Xiaomiju-x/rdk-x5-microduck/software/README.md

# D 短距离前进 · 公开运行包

本次完整方案的推荐软件入口：单一 D 控制台、板端串口运行、400 帧相对轨迹、分段颈部角度、提前收颈、完整单轮与连续 2/3/5 轮、只读检查及托稳慢复位。

建议从 [v2026.10.27.1 固定 Release](https://github.com/Xiaomiju-x/rdk-x5-microduck/releases/tag/v2026.10.27.1) 开始。首次复刻按 [FIRST_RUN](../docs/FIRST_RUN.md) 完成编号、站姿和 IMU 方向；完整安装命令在 [DEPLOYMENT](../DEPLOYMENT.md)。公开包标识为 `D_PUBLIC_CASE_20261027_R1`，用于区分新增诊断与兼容修订，不表示D动作基线发生变化。

**10 月 23 日实机成功的是当时的完整集成与参数。这里的便携运行包从该实现提取，已做离线轨迹、算法和串口目标包对照，未在发布过程中新增实机试跑。** 参数不是所有复刻机器通用的标定值。连续多轮功能已完成软件检查，连续稳定行走仍需实物验证。

## 无硬件快速预览

需要 Python 3.10+。进入本目录，在自己的虚拟环境运行：

```sh
python -m pip install -r requirements-tested.txt
python -m unittest discover -s tests -v
python runtime.py plan --cycles 5
python app.py --demo --port 9194
```

打开 <http://127.0.0.1:9194/>，顶部显示 **DEMO · 无硬件**。运行、复位按钮仅演示界面，不读取串口、不发送目标。已有程序占用 9194 时，换未占用端口；不要关闭正在使用的实机控制器。

`plan` 只读本地文件，输出 `execute=false`、`motion_writes=0`。5 轮为 2000 帧，每轮名义约 8.23 秒，真实串口开销会增加耗时。

## 板端部署

先阅读 [部署与逐机配置](../DEPLOYMENT.md)。软件直接放在 X5 运行，不需要原开发者的用户名、绝对路径或 SSH 配置，也不需要 ONNX 权重和训练服务器。

```sh
python app.py --robot .local/robot.json --port 9194
```

服务仅监听 `127.0.0.1`。电脑通过 SSH 本地转发：

```sh
ssh -L 9194:127.0.0.1:9194 your_user@your_x5_address
```

再打开电脑的 <http://127.0.0.1:9194/>。本地和板端使用同一个端口；如占用，一起改成同一个空闲端口。本机接口还使用同源检查和每次启动生成的控制令牌，避免第三方网页误发动作请求。

启动服务只载入配置和界面。**运行和复位必须由操作者勾选当轮现场状态并点击对应按钮；只读检查可以单独读取串口，不发运动。** 刷新回单轮，现场勾选清空；保存参数和选轮数不发动作。

## 默认成功参数

|参数|默认值|含义|
|---|---:|---|
|启动角度 `bias_deg`|0°|相对本机 START；正值颈根后移、负值前移|
|走动角度 `motion_deg`|−30°|相对本机 START 的前移请求|
|起步保持 `start_hold_s`|0 秒|腿部动作开始后立即进入颈部平滑过渡|
|过渡 `transition_s`|0.2 秒|从启动角向走动角过渡|
|提前收颈 `return_advance_s`|1.1 秒|相对原收颈时刻提前，按 50 Hz 轨迹时间|
|前倾/后倾反馈增益|0 / 0|成功演示采用分段定角，无自动倾斜反馈叠加|

−30°是请求角，每拍颈部变化速率和提前收颈共同决定实际下发过程，不表示实物一定达到或保持前移 30°。`0°`是真正的本机 START。[默认文件](config/success_20261023.json)。

建议单轮起步，一次只调一项并记录现象。启动前倒可增加正向启动角；走动后倒可增加走动前移；收步前倒可逐步增加提前收颈。提示仅针对已核实的 11 号方向，实际效果取决于装配、载荷和地面。

## 完整周期

150 帧准备 → 100 帧历史小动作 → 100 帧平滑回 START → 50 帧保持。提前收颈可与腿部运动重叠。

连续 2/3/5 轮调用相同完整周期，每轮重新建立 IMU 参考、颈部时钟、20 秒期限和读取重试预算。不会只循环中间 100 帧，不自动开启下一批。操作者停止、通信/失能故障、IMU 停更或一轮不完整，均不继续下一轮。

程序完成只说明目标序列完成和最终目标回到 START；是否站稳、是否前移需现场观察。当前 D 是记录目标序列加颈部调节的过渡方案，非完整全身 RL 闭环。

## 文件导航

|文件|用途|
|---|---|
|`app.py`、`web/`|仅 D 的微调台；默认 DEMO，硬件模式显式选配置|
|`runtime.py`|计划、只读检查、姿态捕获、托稳复位、有限轮数运行|
|`imu_diagnostics.py`|独立 IMU 只读检查：两类包频率、轴向、前后倾与数据年龄；不碰舵机|
|`neck.py`|原颈部算法，只修改导入路径|
|`contract.py`|原 D 的包格式、范围、每拍速率检查|
|`feedback.py`、`bounded_read.py`、`confirm_write.py`|真实反馈、有限读取重试、写超时只读确认|
|`imu.py`|JY901S 解码和独立读取线程，不写配置|
|`data/d_trajectory.json`|400 帧逐轴相对 START 增量与原时间间隔|
|`data/reference_pose_NOT_A_DEVICE_CONFIG.json`|历史原型参考，仅供比对，不是新机配置|
|`data/provenance.json`、`data/offline_equivalence.json`|来源、校验和、原实现目标包等价证据|
|`config/robot.example.json`|逐机配置空模板，不能直接发动作|
|`tests/`|假串口、假 IMU、假时钟离线测试|
|`vendor/feetech.py`|上游总线实现，来源和许可见下文|

配置、保存参数、逐轮记录位于 `.local/`，默认已忽略，不要将设备标识和未审阅日志提交到公共仓库。

## IMU 独立检查

填好本机 `imu_port`、`imu_baud` 和候选 `body_from_sensor_rotation` 后，可在尚未确认安装标志时只读验证：

```sh
python runtime.py imu-check --robot .local/robot.json --seconds 8
```

不打开舵机口、不使能、不写目标、不改配置。每约 0.25 秒输出传感器欧拉角/角速度、机体重力/角速度、相对首帧的 `pitch_delta_deg`、数据年龄；结束统计 0x53 和 0x52 的主机接收频率。正的 pitch_delta 表示前倾，负值后倾，必须与支撑状态下的实际倾斜对照。示例矩阵和输出含义见 [FIRST_RUN 的 IMU 部分](../docs/FIRST_RUN.md#5-imu安装方向与只读验证)。

`inspect` 只读舵机，`imu-check` 只读独立 IMU。前者通过不代表后者已通过。结束其他占用 IMU 口的任务后再运行检查；工具不自动将验证标志设为 true。

## 本版离线环境与检查

2026-10-27 在 Windows x86_64、CPython 3.12.14、NumPy 2.2.6、pyserial 3.5 通过 34 项回归（原 24 项 + 10 项 IMU 诊断）。`requirements-tested.txt` 固定此依赖组合；原 `requirements.txt` 保留兼容范围。CI 会在 Windows/Linux、Python 3.10/3.12 运行，不以配置存在代替远端通过记录。

本版新增诊断 CLI 和教程，没有修改 D 数据、neck 算法、成功预设或动作函数。1/2/3/5 轮位置包的原 SHA 断言仍通过。`data/offline_equivalence.json` 是 10 月 26 日原版本历史证据，里面的 runtime 文件 SHA 对应该版本；新增代码的回归证据见 `verification/offline_20261027.json`。

## 停止与复位

- **停止发目标**：结束当前动作，不进下一轮，保持最后目标，不自动失能或猛拉 START。
- **只读检查**：读取 ID、模式、offset、扭矩、位置、目标、电压，不使能。
- **慢复位**：托稳躯干和头部、双脚卸重。先设刚读到的实际位置为目标，再使能失能关节，随后低速回 START。不改 P/D、offset 或 EEPROM。
- **仅复位可恢复关节**：只处理检查通过、离 START 不超过 512 counts（45°）的关节；其余记入 skipped。部分完成不是整机复位。

故障不自动复位，因为设备失联或姿态不明时无法确认回位路径；先支撑、读取状态，再显式决定复位。

## 来源与验证边界

本包新增代码按根 [Apache-2.0](../LICENSE) 发布。`vendor/feetech.py` 来源于 [fanhao375/microduck-replica 的 tools/servo-web 实现](https://github.com/fanhao375/microduck-replica/tree/master/tools/servo-web)，保留上游归属与 Apache-2.0 许可。本修订仅将一处调试日志中的字节串先格式化再插入 f-string，使 Python 3.10/3.11 也能解析；协议、状态解码与动作指令不改。原文件 SHA 与改动说明见 [vendor/README.md](vendor/README.md)，许可见 [vendor/LICENSE](vendor/LICENSE)。结构、媒体及上游模型许可见 [NOTICE.md](../NOTICE.md)。

离线检查包括：400 帧增量和时间间隔与原候选一致；颈算法只改导入；同输入下原运行器与公开运行器 1/2/3/5 轮位置包逐字节一致；停止和故障不续跑；只读捕获无写；复位使能顺序；界面互斥、现场确认和同源访问。不是动力学或新实机稳定性验收。
