Xiaomiju-x/rdk-x5-microduck/progress/2026-10-27/README.md

# 2026-10-27｜24章完整教程与单电池启动进展

**现场实测：复用现有成品5V舵机电池，经微雪DC+/DC−分供后，RDK X5和15个舵机均能正常供电、启动。** 不新增降压或稳压模块；该结果属于当前单电源配置的启动验证。

## 与此前成果的关系

- 10月23日全机载短距离前进视频仍对应双电池配置，不改写为单电池行走。
- 当前确认的是X5与15舵机供电启动；单电池带载行走、连续运行、板端动态电压、温升和续航尚待记录。
- R9竖电池、低位贴身X5和局部让位壳已设计、切片并送印；实配与最终装载表现待验证。
- 本次GitHub更新不连接机器人，不改D成功参数、START、P/D或动作代码。

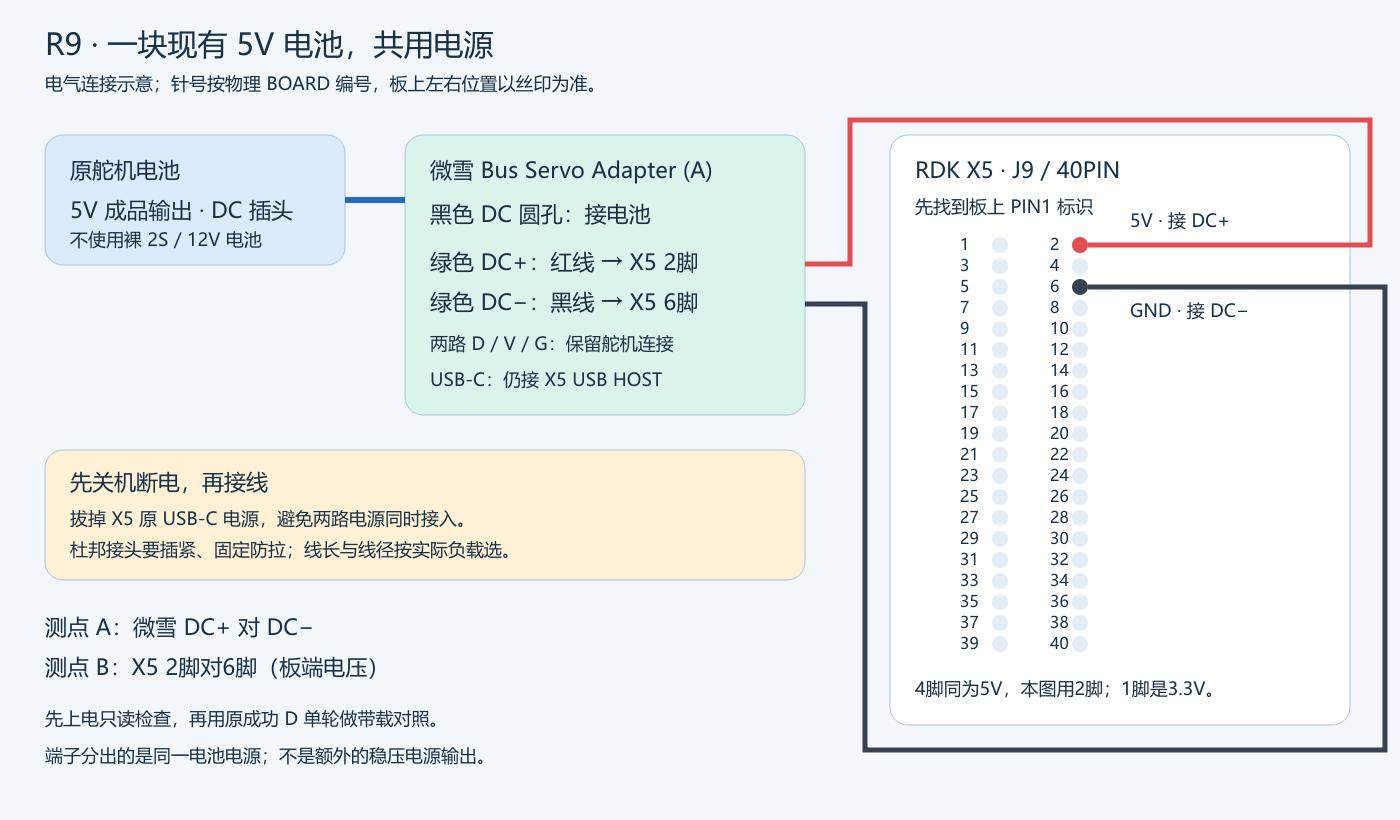
[picture p9: docs/images/r9/power_wiring.png]
单电源接线：已验证启动


来源为项目现场操作者反馈，文字记录见[single-power-startup.json](single-power-startup.json)。目前没有新增单电源动作视频或动态测量数据，不用旧媒体替代。

## 完整教程

新[完整复刻手册](../../docs/FULL_SOLUTION.md)分六篇24章：系统框架、采购、选件打印、分模块机械装配、接线、软件环境、15轴方向、IMU、START、控制台、分阶段微调、日志、MuJoCo实验和RL研究。配图存入仓库，目录和文内资源可直接跳转。

## 下一步

R9实配 → 单电池带载与连续运行验证 → 线束整理 → 同配置D单轮复现 → 2/3/5轮距离扩展 → RL闭环。

以现有RDK X5开发板继续推进，V2机内集成不作为当前迭代的前置条件。详细工作和验收见[ROADMAP](../../ROADMAP.md)与[单电池/R9说明](../../docs/SINGLE_POWER_R9.md)。

地瓜社区同版教程：https://forum.d-robotics.cc/t/topic/35728/1

固定运行/打印包仍为[v2026.10.27.1](https://github.com/Xiaomiju-x/rdk-x5-microduck/releases/tag/v2026.10.27.1)，本次不覆盖旧tag或将尚未实配的R9宣称为已验证打印基线。
