Xiaomiju-x/rdk-x5-microduck/projects/pumpkin-duck/MECHANICAL_NOTES.md

# 机械实装问题与版本说明

**本页是结项问题记录，不是已经验证成功的改装步骤。** 没有因为本次归档新增打印件或要求重新打印。

## 桌面舵机的两侧不能混为驱动输出

现场反馈是：网页发了目标，舵机回读接近目标，外部机构却没有明显动作。用户随后识别到机构连接在从动盘侧。

对原 CAD 继续核对发现，C02 等托架的主动侧连接器插入路径受到阻挡；只把舵机翻面又需要考虑托架背后的安装支撑。此前“简单翻面即可”的建议已撤回。这个问题属于设计/装配可达性漏检，不能归咎操作者或把软件角度放大当作修复。

结项时未提供新的已验收托架，也没有完成主动轴带动各工位的实测。原 C02、H05、E11/E01、F15、G09 等资料仍保留作问题源件，不作为可直接复刻的无误五工位方案。

## 面具快照采用的修正

- 前抱箍用 R1c：两个完整封闭孔，替代原半孔结构。
- 相机托架用 R1a：排针/接口让位版本。
- 语音托板用 R1b：平整泡棉粘贴背板；不使用旧 P06 卡边与两只 P07 隔套。
- 外壳、后抱箍、骨架、灯压片按已有选件保留；本次没有修改几何。

这些是归档文件的版本选择，不是对任意购买模块、插头、打印精度和新增整机载荷的完整保证。参见[零件表](mechanical/mask/README.md)。

## 其他实物修正保留在本地

原 21 盘与已交付修正文件保留，包括舵盘联轴孔、孵化导向与 KW11 胶粘安装图、只换轻薄南瓜壳、格栅导轨及打印方向的修正。用户已打印和装好的部分不因结项重新设计。最后握手叶片开关取消，孵化开关保留。

这些资料可以帮助理解原型过程；整套瓜园的最终装机运动、插头与线束可达性、种子触发和光学效果仍未全部验收。不能从离散 CAD 检查、切片成功或漂亮的装配图推定实物无误。
