Xiaomiju-x/rdk-x5-microduck/ROADMAP.md

# 后续安排：单电源带载升级 → 线束优化 → 更长距离 → RL闭环

更新：2026-10-30。[当前单电源样机](docs/CURRENT_PROTOTYPE.md)已能正常供电、启动和站立；带载行走出现供电不足表现，不能将此前双电池的成功录像作为本版验收。

已采购2S 1000mAh 45C航模电池、好盈5A UBEC、分线/转接线与S10充电器，预计11月2～8日到货，具体以物流为准。近期继续使用现有RDK X5、微雪Bus Servo Adapter (A)、HD1910M与JY901S，不等待V2机内集成。[采购与新接线计划](progress/2026-10-30/README.md)

| 顺序 | 具体工作 | 应交付的结果 |
|---|---|---|
| 新单电源带载 | 2S电池分供舵机与5.0V UBEC/X5支路，做同动作对照 | 两端电压、通信、关节跟随和连续运行记录 |
| 电池与UBEC固定 | 优先复用现有轻量框架，核实固定与02/07侧摆净空 | 正侧背照片、固定方式和活动余量 |
| 线束整理 | 收拢双UART与供电主线，固定接头并留关节余量 | 无夹线和拉脱，接口可维护 |
| 单轮复现 | 保留已验证D基线，按新装载微调起停配合 | 完整起步/前进/收步视频及参数 |
| 距离扩展 | 验证2/3/5完整轮，再研究平滑连续衔接 | 距离、偏航、接护、起停、电量与温度 |
| RL闭环 | 当前实装建模、执行器辨识、训练与部署对齐 | IMU/关节反馈影响全身动作的实机证据 |

## 1. 单电源：从能站立推进到带载行走

旧成品5V电池同时带X5和舵机已经能启动和站立，但带载出现关节跟随无力、复位不到位及低电压回报。新方案已采购，尚未验证：

```text
2S航模电池 → T插一分二
              ├→ DC5521 → 微雪小板 → 15只舵机
              └→ UBEC（输出5.0V）→ RDK X5
```

**更换2S前，拆除旧微雪DC端直供X5的连接。2S电压不得直接进入X5的5V输入。** 原5V直分供接法仅保留为历史实验，不作为新2S方案。

先核输出电压与极性，再做只读检查、支撑慢复位及同动作带载对照，记录X5板端和舵机支路的电压、跟随、通信与温升。舵机回报电压不替代X5输入端测量；新电池未验证前不宣称故障已经解决。

10月23日双电池短距离前进与冻结参数保留为对照；改变电池重量与位置后，还需要重新比较起步、走动和收步的前后平衡。

## 2. R9：竖放电池、X5下移贴身、局部外壳让位

原平放电池横跨较宽，容易进入02/07髋侧摆活动区；早期远悬背包又增加后坠力矩和连接负担。本轮把减重、缩短悬臂和关节净空一起处理，优先减少一块电池和不必要支架。

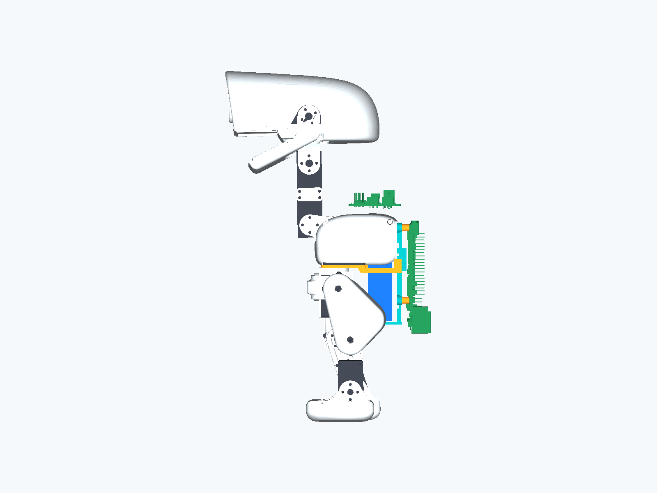
[picture p12: docs/images/r9/R9_side.png]
R9候选布局，待实配


- 电池按40×19×70mm竖放，70mm长边竖起，横向占位由70mm改为40mm。
- X5相对保存的R8A CAD下移24mm、内收约3.64mm。这是CAD差值，不是成功照片的实测差值。
- 新L1根座、L2轻量托架、C1/C2局部让位壳各1件，旧四个6mm隔套复用。
- 先离机装螺母、隔套和PCB，再放电池并接入根座，保持螺母装入与工具空间。
- 微雪使用固定躯干部位的合适位置，保留IMU已确认的刚性安装和朝向；胶粘和线束不进入活动关节。

已完成内部干涉、93个离散姿态、紧固叠层和螺母装入路径检查，切片并送印。整盘约53.83g、2小时44分是含替换壳和支撑的估计，不是新增背包净重；移除一块电池历史约84g，最终总质量和质心仍需实测。

现有单电源实装已经能够站立；新电池和UBEC到货后继续核对固定方式、02/07侧摆、真实线束包络和根座承载，再做同D动作对照。当前仓库制造资产仍为R8A，R9本次同步说明与示意图，不把设计检查当作强度或带载行走验收。见[R9专章](docs/SINGLE_POWER_R9.md)。

## 3. 减少线缆裸露和跨关节绕线

**目的：** 降低勾线、插头松动和线缆牵拉对行走的影响，提高整机一致性与展示完整度。

优先安排：

1. 利用已接入的40PIN双UART，沿固定躯干集中布置IMU、微雪通信和动力主线，缩短过长的回绕线。
2. 给连接器增加适当的应力释放与固定点，线缆不承担电池或板卡重量。
3. 每个活动关节仅保留必要活动余量，避免在双腿之间形成大线圈。
4. 给X5与微雪设计轻量导线槽、局部护盖或卡扣；不先增加厚重整包外壳。
5. 保留电源开关、USB、调试接口、散热与检修空间，并给两条供电支路和总线做标签。

验证时覆盖髋、膝、踝、头颈的实际使用姿态：无拉紧、夹线、明显剥离和插头受力。记录新打印件与线束的增加/减少质量，用正侧背三面图更新装配教程。

## 4. 从短距离前进扩展到长距离

**当前起点：** D单轮的腿部片段与颈部参数已保存；控制台提供完整1/2/3/5轮。每轮都有准备、动作、回位与保持，多轮入口不等于连续无停顿步态。

推进顺序：

1. 保持同一硬件、地面、电量和参数，记录单轮起步及收步的重复性。
2. 由操作者逐级测试2、3、5完整轮，记录累计距离、偏航、是否接护、每轮起止状态。
3. 区分“某一轮失稳”和“轮间重新准备导致的偏移”，再决定是否设计连续衔接动作。
4. 进入更长距离时，持续记录关节跟随、供电变化、温度与运动频率，不单纯扩大摆角。
5. 选定目标距离和场地后再冻结对应配置，用完整连续视频和原始日志说明测试条件。

建议记录表：

| 版本 | 地面 | 电量/电源 | 轮数 | 实测距离 | 接护次数 | 最后站稳 | 偏移方向 | 日志/视频 |
|---|---|---|---:|---:|---:|---|---|---|
| 按实际填写 | 按实际填写 | 按实际填写 | 1/2/3/5 | 测量值 | 观察值 | 是/否 | 前/后/侧 | 文件名 |

长距离阶段的成果以具体测试记录确认，不把软件帧数直接换算成行走米数。

## 5. 验证真正的RL实时闭环

**目的：** 让控制器根据实时姿态、角速度、关节位置和速度持续产生动作，逐步获得适应扰动、负载和起停的能力。

与当前D的区别：D主要使用记录的腿部目标序列和颈部时序；IMU数据接入、故障检查和舵机自身位置控制，并不等于全身RL平衡策略已验证。

| 环节 | 后续工作 | 检查结果 |
|---|---|---|
| 实物参数 | 测实际装载后的质量分布、START几何、执行器带载响应、通信时序与脚底接触 | 用测量替代旧照片估计；保存模型与实物版本对应关系 |
| 仿真模型 | 从本次FT教学模型继续，补正确惯量、附加载荷、执行器、延迟和接触条件 | 静态姿态、逐轴方向、小幅响应与实物对照 |
| 训练环境 | 固定观察量、动作顺序、缩放、滤波、历史状态、命令与奖励 | 训练/导出/运行三个阶段一致的配置文件 |
| GPU训练 | 有需要时使用RTX5090资源训练和评估 | 记录环境数、步数、随机种子、代码版本与权重，不以有GPU代替验证 |
| 离线评估 | 站立、前进、收步、延迟与载荷变化 | 分任务评估，记录失败样例和指标 |
| 实机部署 | X5读取IMU与关节反馈并推理，依次做卸重、零速接管、短前进和长前进 | 完整日志与现场视频共同确认，不将悬空正常等同带载行走通过 |

D基线继续保留用于设备检查与结果对照。新策略作为独立版本，不覆盖已经成功的参数与轨迹。

## 6. V2与项目分工

- **RDK主线：** 现有X5开发板原型按新单电源带载对照、固定与净空、线束、单轮与长距、RL闭环推进，形成可复刻、可比较的版本。
- **V2硬件：** 与硬件同事协作推进X5 Module和专用底板机内集成，结合单电池、配电和线束布局设计；不沿用外悬重背包作为最终形态。
- **陆吾XGO-Duck副线：** 作为独立平台的行走和部署对照，不把它的模型、舵机零位或策略直接写入FT鸭子。
- **南瓜鸭副线：** [2026-10-30 已结项归档](projects/pumpkin-duck/README.md)，不再主动开发、训练或安排联调。[面具的感知/表达与瓜园互动拓展](projects/pumpkin-duck/EXTENSIONS.md)只保留未完成设计，不并入主线排期。

当前版本可以用于社区复刻和交流，以上工作按结果逐步发布，不承诺未经验证的完成日期。参与方式见[贡献指南](CONTRIBUTING.md)。
