Xiaomiju-x/rdk-x5-microduck/docs/PROCUREMENT.md

# 采购与打印清单：买对一套 RDK X5 Duck

> **最新进度｜2026-10-30：** 当前单5V电池样机已能正常供电、启动和站立，带载行走出现供电不足表现。已采购2S 1000mAh 45C电池、好盈5A UBEC（5.0V供X5）、分线/转接线及S10充电器，预计11月2～8日到货验证。[完整采购清单、新接线与后续安排](../progress/2026-10-30/README.md)。下文10月27日电源说明保留为历史；旧DC端子直供X5的接法禁止用于新2S电池，新方案尚未验收。

本页面向首次搭建者，配套 [硬件连接](../HARDWARE.md)、[完整装配](../ASSEMBLY.md) 和 [逐步验收表](BUILD_CHECKLIST.md)。资料核对日期：2026-10-27。表中保留10月23日双电池成功样机的采购基线。最新单电池方案已复用现有成品5V舵机电池，从微雪DC+/DC−分供X5和15舵机并正常启动；移除X5专用电池、暂不新增降压模块。带载与连续运行待验证，详见[最新接线与R9](SINGLE_POWER_R9.md)。

## 1. 先选对版本

| 要复刻的部分 | 本案例选定 | 不混用 |
|---|---|---|
| 执行器与本体 | FT / HD1910M，15轴 | XL330结构、陆吾关节零位、STS3215接口 |
| 机载主机 | RDK X5完整开发板 | X5 Module、Raspberry Pi Zero占位件 |
| 串口转接 | 微雪Bus Servo Adapter (A)，USB控制档 | 普通双线UART当作三线舵机半双工总线 |
| 结构增量 | R8A L1、L2、6mm隔套 | 旧远悬背板、旧R8未开下螺母通道L2、8mm隔套 |
| 足底 | FT左右原形状，TPU95A HF | 把硬脚掌或踝座也换成TPU |

## 2. 电子件：可直接给采购同事的规格表

“本台记录”描述已经使用过的设备；“选购条件”供新复刻者核对。没有公开确切SKU的项目用完整规格和搜索词，不用外形相似的商品链接冒充本台原件。

| 项目 | 数量 | 本台记录 / 必须核对的规格 | 官方入口或采购搜索词 |
|---|---:|---|---|
| RDK X5开发板 | 1 | 完整开发板；预留电源USB-C、USB HOST与microSD；本资料未登记本台RAM档位 | [官方硬件说明](https://d-robotics.github.io/rdk_x_doc/en/Quick_start/hardware_introduction/rdk_x5/)；搜索“地瓜 RDK X5 开发板” |
| microSD | 1 | 容量满足所选官方镜像及日志；购买可靠品牌，按镜像文档准备读卡器 | 与所选RDK镜像要求一致；不把本案例写成某一容量实测 |
| 飞特HD1910M总线舵机 | 15 | FT源包标为HD-1910-C001；核对实物HD1910M、舵盘凸台、随附螺丝/线材、固件寄存器及模式；机械方案含单/双盘装配 | [FT v2.0来源](https://github.com/fanhao375/microduck-replica-cad/releases/tag/v2.0)；搜索“飞特 HD1910M HD-1910-C001 TTL总线舵机”，向厂家确认所供版本 |
| 微雪Bus Servo Adapter (A) | 1 | SKU25514；板框42×33mm；USB-C数据，DC5521，2路相同总线口；USB模式为B档 | [微雪国内产品页](https://www.waveshare.net/shop/Bus-Servo-Adapter-A.htm)；[规格](https://docs.waveshare.com/Bus_Servo_Adapter_A) |
| JY901S IMU | 1 | TTL串口款；本程序使用115200 baud、0x52角速度/0x53欧拉角，约50Hz；不同出厂默认值需配置 | 搜索“维特智能 JY901S TTL”；[厂家协议SDK](https://github.com/WITMOTION/WitStandardProtocol_JY901) |
| USB-TTL适配器 | 1 | 实机确切芯片SKU未登记；Linux驱动可用、TTL电平匹配IMU、115200稳定；不能买RS232/RS485款替代 | 搜索“USB TTL 串口模块 Linux 3.3V 115200”；CP2102/CH340等仅为候选类别，购买前核对电平与驱动，未作为本台同款认证 |
| 舵机成品稳压电池 | 1 | 历史购买规格5V/0–3A、2400mAh，DC输出；设计包络70×40×19mm，单块历史称重84g，线约15cm；精确店铺SKU未归档 | 搜索“5V 稳压锂电池 2400mAh DC5521 70×40×19”；要求商家给持续/峰值电流、极性、保护与充电说明 |
| X5成品USB-C电池 | 双电池基线1；单电池方案移除 | 同类外形、5V USB-C输出；本台额定电流及完整SKU没有独立归档，不能按另一块铭牌推断 | 搜索“5V USB-C 输出小电池 70×40×19”；确认是输出端、低负载不会自行断电、线与接头有足够电流能力 |
| 初期联调X5外置电源 | 1 | 按RDK官方要求5V/5A电源与匹配线缆；已有合规电源可复用 | [RDK硬件与供电](https://d-robotics.github.io/rdk_x_doc/en/Quick_start/hardware_introduction/rdk_x5/) |
| 舵机联调外置适配器 | 1，可复用 | 本项目曾用5V/4A外置适配器；输出电压必须匹配所购HD1910M，不能照板上ST系列电压字样选12V | 搜索“5V 稳压电源 DC5521”，核对极性和电流；板卡官方FAQ标称可承受5A，不等于所有线束可持续5A |
| USB-A→USB-C数据线 | 1 | X5 HOST至微雪；必须有数据线芯；尽量短且接头牢靠 | 搜索“USB A to C 短数据线”，按实际布局量长 |
| IMU USB线与排线 | 1套 | 适配器接口匹配，VCC/TX/RX/GND标清；供电与逻辑电平分别确认 | 与IMU/适配器配套，按引脚定义逐线核对 |
| 舵机三线总线 | 15段连接关系 | 两路树形分支，共含2根小板引出线及13根舵机间线；可复用厂家附线，按每段测量长度 | 搜索时携带舵机插头照片和针距；只写“杜邦线”不足以保证接头匹配 |

本表保留已成功样机的电池记录，但不把“本台短动作成功”扩展成这套电池覆盖15轴所有动作或X5满算力。复刻初期先把外置供电下的接线和控制跑通，再独立验证机载供电。无需为本D动作额外购买GPU、NPU扩展板或摄像头。

### 线束数量怎样来的

第一支路为左腿5只＋头颈嘴5只：1根板端线＋9根舵机间线。第二支路为右腿5只：1根板端线＋4根舵机间线。因此总计15段，不包含USB、IMU排线和两电源线。段数是拓扑计数，接头类型和每段长度依实际走线；不要把两支路末端再跨接成环。

## 3. 金属五金和工具

### 可确定的用量

| 项目 | 用量 | 用途及计数依据 |
|---|---:|---|
| 16×22×4mm金属轴承（内径×外径×宽） | 11 | FT作者用量，且固定FT总装树中相应大轴承实例11个；按每个圆座逐位装入 |
| 10×15×3mm金属轴承 | 3 | 两踝及下巴支撑；不是轮滑6×12×3占位对象 |
| M2.5×8螺丝 | 7 | 头内横梁4＋头盖3；头下长度，适合接收塑料孔的牙型按FT原件核对 |
| M3×16螺丝 | 2 | R8A L1/L2连接 |
| 普通M3螺母与M3平垫 | 各2 | 同上 |
| M2×12螺丝 | 4 | X5四孔，配6mm隔套 |
| 普通M2六角螺母与M2平垫 | 各4 | 同上；M2螺母约对边4mm、厚1.6mm，非加厚法兰款 |
| FT原腿根尾端螺钉 | 4，复用 | L1安装；不能拿舵盘中心螺丝代替 |
| 细绑带 | 原托盘2条；侧贴按实装 | 约10mm宽、≤1mm厚以配槽，长度先用软尺测量 |

舵机壳体/舵盘周边连接优先使用该批HD1910M原配小自攻。**整机原配小自攻总数和部分壳体固定长度尚未形成逐孔冻结表**；上游仅列“若干”的M2×5，不能替换成虚构的总数。采购时要求厂家随15只舵机提供足量安装包，并按[装配模块](../ASSEMBLY.md)清点；小自攻、M2机牙、舵盘中心螺丝不可混作一种。缺口填入下方预算表的“待确认”列，不当成零成本或已齐套。

### 工具与辅料

- 与实际螺丝头匹配的小号螺丝刀/内六角、镊子、尖嘴钳、模型剪钳、去支撑工具。
- 卡尺：核对孔、轴承、螺母和电池尺寸；万用表：核对供电极性与电压；秤：记录最终整机及附加件质量。
- PLA、TPU95A HF分别准备；高粘泡棉作固定与消隙，板底另留电气绝缘，不用线缆承重。
- 标签纸标每个舵机ID和打印件号；扎带、柔软束线带及线缆固定点。
- 平整防滑测试面与便于托举的工作区。打印机可自有或外包，不要求购买同型号打印机。

## 4. 打印清单：当前机载基准

| 组 | 文件入口 | 数量 | 材料 |
|---|---|---:|---|
| FT本体选定件 | [body_parts](../mechanical/body_parts/README.md) | 28个文件，各1件 | PLA |
| R8A根座 | `L1_R8_short_FT_root.stl` | 1 | PLA |
| R8A X5支架 | `L2_R8_flat_battery_portrait_X5.stl` | 1 | PLA |
| X5隔套 | `S1_R8_PCB_spacer_6mm.stl` | 4 | PLA |
| 左右脚底 | [tpu_soles](../mechanical/tpu_soles/) | 各1 | TPU95A HF |

基准共 **34个硬件实体＋2个TPU脚底**。28本体件包含眼圈和面板；可选软嘴018/044不计入，也不意味着成功样机使用这两件指定软料。R8A的L1替代上游052底板，故本体从29减为28。详细52对象决策：[FT_PRINT_SELECTION.csv](FT_PRINT_SELECTION.csv)。

不要打印：旧踝002/004、旧轴承压盖008/065、轮滑支架042/064、轮毂040/060/061/066、轮胎058/087/088/089、轮滑轴承占位063/067。原PCB锁扣006、镜头座025、原电源支架036也不进入这条X5外挂路线；027是**头内电机支架**，必须保留。

本体STL已经选定；本项目3MF提供R8A六件一盘、L2单件替换盘、左右TPU一盘，均需重新切片。整机本体按自己的机器安排盘数；不把P2S原工程直接发给P1S。

## 5. 可编辑源文件与固定版本

| 资料 | 固定下载 | SHA-256 |
|---|---|---|
| FT SolidWorks全套 | [SolidWorks-FT.zip / v2.0](https://github.com/fanhao375/microduck-replica-cad/releases/download/v2.0/SolidWorks-FT.zip) | `13764d844acec914b9e90fbf18f611d3d1c60b845a160710e0d694701cdba9b1` |
| FT改动STEP | [STEP-changed-parts-FT.zip / v2.0](https://github.com/fanhao375/microduck-replica-cad/releases/download/v2.0/STEP-changed-parts-FT.zip) | `cf137cd3c20b1ee115c5ba71993b42a993c9da337551a7f691d77870f5a61b0a` |
| 原始五盘3MF | [固定提交的打印目录](https://github.com/fanhao375/microduck-replica-cad/tree/22ecf4daea158f2dfad7b633f730a5c04f1e04e0/打印) | 原`microduck-飞特版-BambuStudio.3mf`：`de34a7808f97b3cc2b66dd24db94ddbe2fcd3b18691562f48dad3a094ecb5862` |

上游已存在更新版本，本案例固定既有FT基线以保证接口和选件可追溯；升级时单独对比尺寸，不在复刻过程中自动拉“latest”替换某一个件。只有9份改动STEP不能替代全套CAD；28本体STL加本包增量件则覆盖这里列出的打印基准。

## 6. 预算与用料如何填写

本次没有拿到可核对的完整订单金额，所以不发布猜测的“整机只需多少元”。建议复制下表，填自己下单当日含运费价格；已有部件可填0并注明复用，数量按上文清点。

| 预算项 | 计算方法 | 当前金额 |
|---|---|---|
| X5＋卡＋读卡器/电源 | 实际订单合计，去除已拥有项 | 待本次采购报价 |
| 15舵机＋原配附件＋总线 | 单价×15＋缺线/螺丝补件 | 待报价 |
| 微雪＋IMU＋USB-TTL＋USB线 | 逐项实价 | 待报价 |
| 两机载电源 | 2个实际SKU＋所需充电器/线 | 待报价 |
| 轴承/紧固件/泡棉 | 按规格表，不以“套餐数量”代替用量 | 待报价 |
| 打印 | 当前切片总克数×耗材每克成本＋外包/电费 | 按新切片记录 |

可供规划的历史记录：2026-09-14，P1S/0.4/PLA/0.2mm/6墙，**旧29件本体**六盘切片估计273.24g、12小时49分09秒，含当时支撑；不含软嘴、TPU脚底和现R8A增量。这不是当前34硬件＋2脚底的总用料或实际打印耗时。当前总量应从本次切片预览重新汇总。

## 7. 下单前最后核对

- 舵机外形、主动盘、副盘与FT图纸相符，15只的模式/寄存器版本可识别。
- 两电池分别具有**所需输出接口**；USB-C插孔不必然是输出，DC插得上不必然极性相同。
- 微雪是(A)版，USB数据线能通信；两只D/V/G为同一舵机总线。单电池方案从绿色DC端分供，按专章核对5V、物理针脚、导线与接头，启动验证不代替总负载测试。
- 正常金属轴承、正确牙型螺丝和X5下孔螺母已齐；不可打印轴承代替。
- 用选定STL/清单重新切片，确认最终装载方案没有额外打印一整套旧背包。

厂商资料负责接口规格，本案例负责实际集成路径；没有明示“实测同款”的替代件，均需自行验证。来源与许可见[NOTICE](../NOTICE.md)。
