Xiaomiju-x/rdk-x5-microduck/progress/2026-10-23/README.md

# 2026-10-23｜突破性进展：全套硬件上身后实现短距离前进

RDK X5机器鸭从“桌面外接控制链路”走到了“计算、驱动与供电随体”的新阶段：**X5、微雪小板和电池全部安装到本体后，已完成短距离前进，展示末段仍保持站立。** 这是本项目机载集成与带载运动的重要突破。

## 实拍证据

[▶ 完整实拍视频，约13秒](../../media/20261023/onboard-short-walk.mp4)

前段是短距离前进，后段展示整机与机载硬件。公开副本仅压缩编码并移除定位等元数据，未截断、倒放或改变播放速度；视频总时长不是连续前进时长。没有用未标定镜头估算厘米数。

| 正面 | 侧面 |
|---|---|
| 正面实拍 | 侧面实拍 |

两张照片展示当前装载状态，不能代替精确质量、质心或惯量测量。

## 控制方式与冻结配置

本次使用D历史小动作：固定的历史下发目标片段，叠加**仅11号颈根的分段定角与提前收颈**。其余14轴目标及节奏不因颈部微调而改变，不运行全身在线RL策略。

| 控制台项目 | 本次保存值 |
|---|---:|
| 启动颈根角，相对本机START | 0° |
| 走动颈根角，请求值 | 前移30°（代码为−30） |
| 小动作开始后保持 | 0秒 |
| 走动角过渡时间 | 0.2秒 |
| 提前收颈 | 1.1秒 |
| 自动前倾／后倾反馈强度 | 0／0 |
| 反馈上限／死区（强度为0时不产生补偿） | 前后各4°／1° |

[冻结参数JSON](parameters.json) · [新增控制模块与离线测试](control/)

- 正值向后、负值向前是**本台11号实测方向约定**；0°表示已有START目标，不是机械绝对零位。
- 30°是请求值。颈部原有每拍5计数速度约束仍在，短时间内实际或已发送角度可能尚未达到请求值。
- 1.1秒按50Hz轨迹名义时间计算：原第250帧开始的100帧平滑收颈，提前55帧到第195帧。不是瞬间回颈，也不是把原收颈过程压缩成1.1秒；总线耗时可能拉长实际时间。
- 本次两项自动反馈为0，不能将成功归为IMU实时自动纠正。此前全身RL、IMU与关节反馈研究为独立路线。
- 最近同参数程序记录完成400帧、6030次正确回复、0超时/校验错误；程序完成不替代现场效果。录像和日志没有硬件时钟同步，不作逐帧因果断言。

## 工程经验与下一步

关键不只是“把动作幅度调大”，而是把起步、走动、收步所需的身体配合分开处理。这次在能前移的目标片段基础上，仅对颈根角度和提前回位时机做微调，保留了可用的腿部动作；历史失败视频和结构装配记录继续保留在仓库。

接下来巩固固定条件下的重复起停、改善更长距离稳定性，并推进轻量化与V2机内电控集成。本次是原型的功能突破，不是长期可靠性、任意地面或自主导航验收。

## 主线与副线

- **RDK X5 Duck主线**：本次成果、参数和实拍归属本线，继续负责机载集成与行走。
- **陆吾 XGO-Duck副线**：Arduino UNO Q独立平台已完成装配、15轴标定、站立和1秒/3秒短程前进的现场验证；实际距离未测，直线保持和转向继续验证。复用官方资料：[硬件](https://github.com/LuwuDynamics/xgoduck_hardware)、[Arduino运行框架](https://github.com/LuwuDynamics/xgoduck_runtime_arduino)、[RL框架](https://github.com/LuwuDynamics/xgoduck_rl)。不搬用其零位、ID或策略验收结果替代RDK验证。
- **南瓜鸭副线**：主题打印件与装配图、数字瓜园和互动机构持续推进；Web/Godot/MuJoCo与UE5可玩版已有阶段交付，实物装配与互动联调尚需接续，数字场景不等于实体已完成全部功能。

在团队支持下，由**CanNyCat（Xiaomiju-x）主导项目推进与实机集成**；机械、机器人框架及上游算法归属仍见[来源与许可](../../NOTICE.md)。
