Xiaomiju-x/rdk-x5-microduck/CONTRIBUTIONS.md

# 项目贡献与致谢

本项目是在团队支持下推进的 RDK X5 机器鸭实体原型实践。

**CanNyCat（GitHub：Xiaomiju-x）主导本阶段项目推进与实机集成**，主要承担方案选择与开源复用、物料与打印协调、整机装配及问题处理、15舵机编号/方向联调、X5控制链路和IMU接入、现场步态试验、参数微调、视频记录与工程文档整理，并推动从双关节验证到整机短距离行走的阶段交付。

实现过程中使用AI辅助编码、资料整理和调试分析；物理装配、现场操作与效果确认由项目推进者完成。项目进展也得到了团队、指导同事及硬件同事的支持。此职责说明不是对全部上游设计的原创或独占权声明。

感谢：

- **Pollen Robotics**：Microduck机器人、官方仿真/训练/运行生态。
- **机械行者Robo**：FT复刻可编辑CAD及装配资料。
- **fanhao375**：复刻资料整理、相关工具和舵机总线实现参考。
- **Rhoban / Open Duck 社区**：Placo与参考步态生成工具。
- 地瓜社区及团队同事：平台资源、交流与项目支持。

个人GitHub用于本次经用户明确授权的项目开源整理；不将上游署名移除，不暗示本项目获得上述作者的官方背书。
