Xiaomiju-x/rdk-x5-microduck/PITFALLS.md

# 失败案例与关键判断

失败材料与阶段成果同时公开，是为了让后来者少走弯路，不是把探索过程包装成一次成功。

## 1. 有动作不等于脚离地，也不等于行走

早期会出现腿在扭动、脚底拖着走、缓慢挪动但仍失稳。只问“有没有动”不够，应区分悬空屈伸、实际抬脚、前移、是否接护、收步后站稳。调试程序完整执行不能替代现场观察。

## 2. 悬空正常，承重不跟随

[失败视频：承重时前倾](pitfall-loaded-tracking.mp4)保留了手接护的过程。

我们对同一组 sent_targets 做悬空/落地对照。右膝最大跟随差约23.38°降至3.96°、右踝约29.44°降至4.31°，提示承重相关执行链差异。右腿原先经过左腿末端串接，改为小板短支路后误差改善，但两次试验的人工接护、线缆、时序等并非完全一致，不能单凭这些数字宣判唯一电源根因或电机损坏。

## 3. “同参数”不等于“同动作”

在线策略根据新的IMU和关节反馈重算。最初说“保留原前两秒”只保留了逻辑，目标序列却不同。后来用当次实际 **sent_targets** 核对，动作100拍全15目标才真正一致。即便如此，相同目标仍不保证相同实际轨迹：姿态、受力、接触、线缆、供电和执行时序都参与结果。

## 4. actual 不是可以随手复播的 target

sim actual包含执行器跟随后的结果；再把它当位置目标，相当于再次经过执行器动态。原模型离线对照中，这会显著改变运动；固定上身只播八腿也不是完整官方策略。当前演示改用记录的下发目标，不复播实测actual。

## 5. 策略接管、切换与收步必须分开看

[失败视频：动作幅度变化与接护](pitfall-policy-transition.mp4)。用户观察前段小动作能慢慢前移，随后幅度增大时前倒。日志表明其中存在standing→walking策略切换，但相同片段复测仍可能失稳，因此切换不是已证实的唯一原因。

0.6秒交叉过渡改善过中段体验；后续为阶段演示采用有限目标片段及缓回站姿。不能将这一方案宣传为完整在线RL任意速度行走。

## 6. 颈根补偿不能只追求“大一点”

11号增加计数已实测为后倾。前倾时给后移补偿可以改变重心与姿态，但过大响应也可能转为后倒。微调台把增益、最大后倾、死区拆开，配重位置另记，每次只变一个条件更有可比性。

本阶段记录为增益0.375、上限4°、死区1°；限制角不是每轮都真的移动到4°，实际补偿由姿态反馈决定。脖子、腿部方向检查发现并纠正过旧符号错误，不能沿用旧文档猜符号。

## 7. 保护逻辑也要区分现象

普通电压波动/瞬时跟随滞后用于后台记录，不能在步态中间无依据频繁打断。另一方面，真实失联、无新IMU数据或头部舵机复位失能不能伪装成正常完成。软件停止发目标也不是断电急停：仍可能停在不稳姿态，需要旁人接护和托稳复位。

## 8. 总重、质量分布与背包

没称重不代表完全不能继续做有限试验，也不代表模型惯量已经匹配。当前已看到配重位置会改变结果。下一阶段把桌面设备背上去，会新增质量、CoM偏移和转动惯量，必须作为新配置验证，不能直接沿用本次视频为集成版验收。

## 本轮证据边界

最新20秒视频是短步与硬件展示，不是20秒连续行走。控制记录与录像没有硬同步，不能把文件名时间精确等同某一帧姿态。公开遥测只用于说明链路和参数，不能独立判断当时有没有被手接住。
