Xiaomiju-x/rdk-x5-microduck/projects/pumpkin-duck/STATUS.md

# 结项状态与证据边界

结项日期：**2026-10-30**。状态：**CLOSED / ARCHIVED / NO ACTIVE DEVELOPMENT**。

## 实物、数字与展示资料

| 内容 | 实际已有结果 | 未完成或不能据此推定的内容 |
|---|---|---|
| 机器鸭本体 | RDK X5、十五轴飞特机体；历史主线有短距离前进视频 | 当前完整南瓜载荷的长期稳定行走、全身实时 RL 和整套互动未验收 |
| 南瓜面具 | 白色实物、可拆抱箍、相机/语音硬件和灯眼结构；有修正版本快照 | 访客识别、活动词表、口令回应与灯声动作闭环未完成 |
| 桌面瓜园 | 多模块打印和机械装配；独立五舵机编号 2–6 有记录 | 主动轴/从动盘与插头净空适配尚有问题；整套电动联调和真人完整流程未完成 |
| KW11 与 LED | 保留孵化开关和灯光接线方案；最后握手叶片开关取消 | 不能称所有灯、开关和机械均已接入并验证 |
| Web / UE5 | 本地可玩场景、录制动作接入及 V1 / V2 流程测试记录保留 | 实体互动、实时实机策略、用户主观最终验收与全场稳定 60 FPS 不能由此推定 |
| 活动展示 | 中英文介绍、照片、Demo、作品 PPT、Group 03 页和五版中英讲稿已制作 | 资料准备不等于所有原定功能完成；不据此宣称获奖或具体评审结论 |

## 历史行走与电源

公开的[2026-10-23 原片](../../media/20261023/onboard-short-walk.mp4)约 13.25 秒，前段为短距离前进、后段为硬件展示，不是连续行走 13 秒。该片为主线双电池配置，不能改写成南瓜整套互动或当前单电源带载验收。

10 月 27 日的单 5V 电源结果确认到供电启动。主线[10 月 30 日进度](../../progress/2026-10-30/README.md)另记载后续带载供电不足及新的 2S / UBEC 方案；不能再把旧启动结果说成电源全验证通过。本南瓜副线不继续承担新电源或主线步态工作。

## 数字动作与测试：历史数据冻结，不重新运行

本地 R5 Overlay18 记录了：

- 13 段名义物理录制动作；Windows 物理复核 13 项，跨平台归一化/推理对照 900 组。
- 冻结扰动测试 **93/100**，其余未通过。统一实时策略未获资格，**不允许据此部署到实体机器人**。
- 同一独立包 V1 完整流程 3 轮、V2 正常/改道/等待/遮挡/缺货五个场景及 34 个内部回调步骤；这些是数字版测试。
- 性能采样为 RTX 4050、DX12 离屏、1080 输出/内部 85%，不含 Windows 窗口呈现。V1 保留约 615 秒平均约 68.52 FPS；V2 缺货场景约 44.80 FPS，不能称全场稳定 60 FPS。
- 游戏使用 `physics_rollout_replay`，角色位移仍由游戏控制；不是实时物理策略或 sim-to-real 验收。

数据与版本标识保存在 [status.json](status.json)。本次仅整理已有记录，没有重启训练、游戏测试或实机。

## 仍然有效的问题

1. 原桌面托架与主动输出/从动盘布置不匹配，连接器插入路径被挡；仅翻转或更换软件方向不是已验证修复。
2. 舵机编码反馈到目标不能证明外部机构实际运动，更不能证明送籽、孵化或光学效果成立。
3. 数字等待/遮挡/缺货分支与真实传感器闭环分别记账。
4. 装配和打印版本存在历史修正，应按选件版本识别；不把最早整包当最终无误制造包。

## 结项后处理

保留源码、CAD、修正图、现有制造文件、失败证据、数字包和展示材料；只保留[未完成拓展设计](EXTENSIONS.md)，不安排继续开发。本副线夜间自动化已停止。主线机器人、陆吾对照项目及既有固定 Release 独立，不随南瓜副线结项而撤销或关闭。
