Xiaomiju-x/rdk-x5-microduck/docs/images/system-overview.png

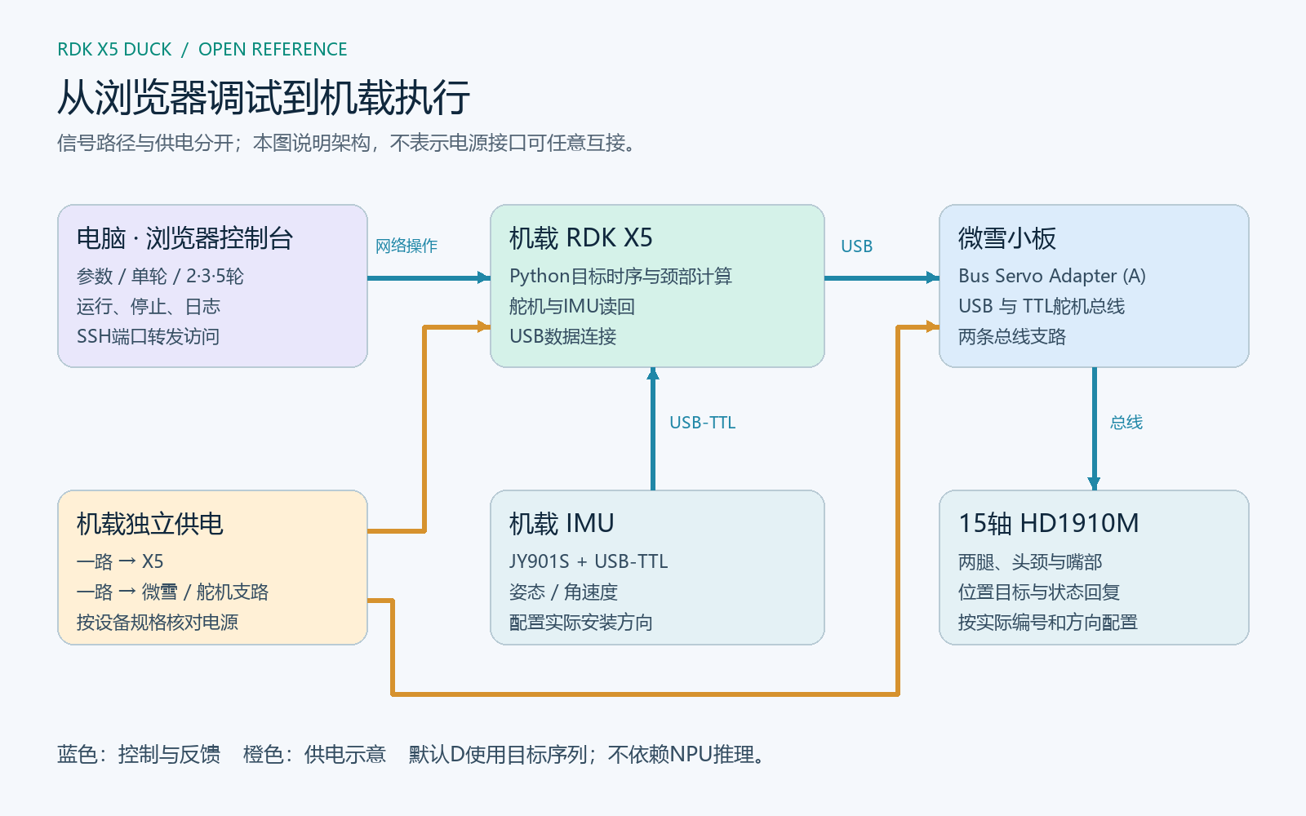
docs/images/system-overview.png
