Xiaomiju-x/rdk-x5-microduck/projects/pumpkin-duck/media/five-petal-box.jpg

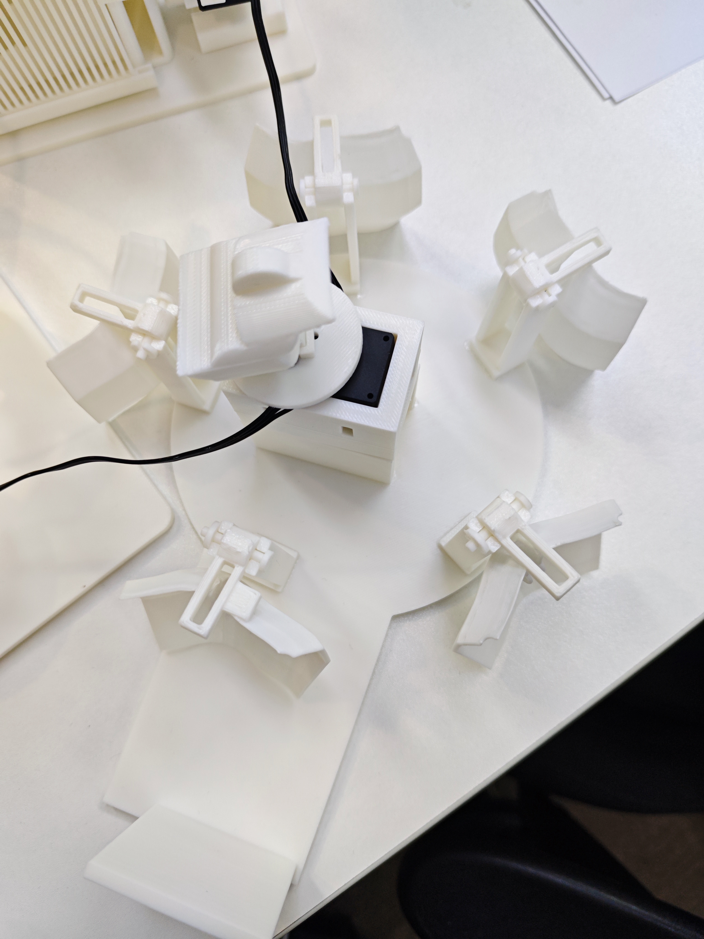
projects/pumpkin-duck/media/five-petal-box.jpg
