Xiaomiju-x/rdk-x5-microduck/projects/pumpkin-duck/media/hatching.jpg

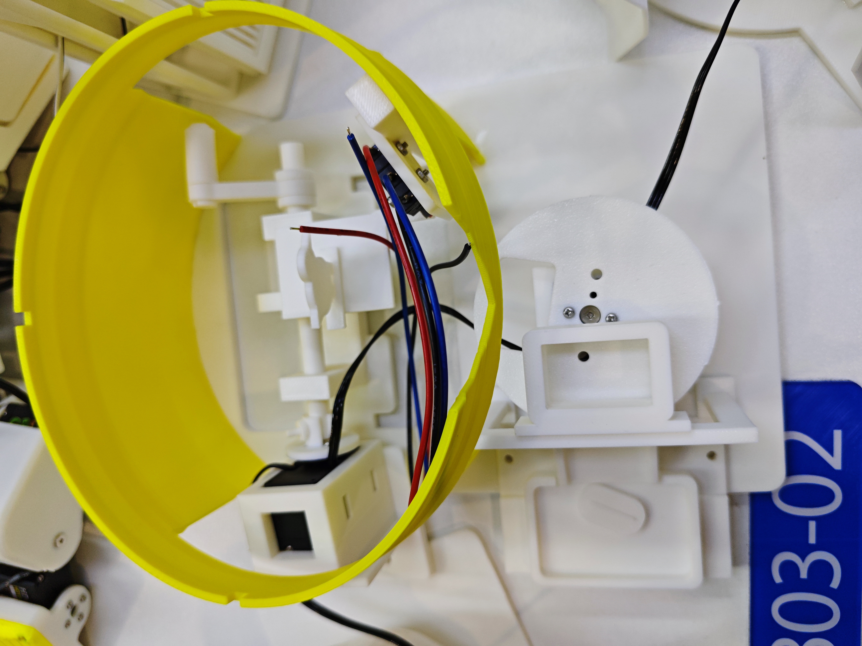
projects/pumpkin-duck/media/hatching.jpg
