Xiaomiju-x/rdk-x5-microduck/projects/pumpkin-duck/media/phantom-grille.jpg

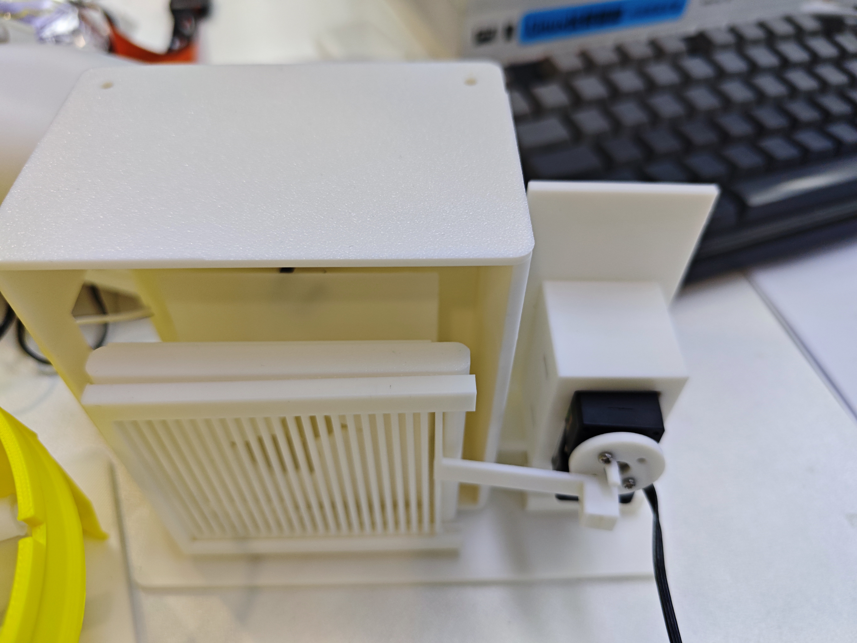
projects/pumpkin-duck/media/phantom-grille.jpg
