Xiaomiju-x/rdk-x5-microduck/docs/FT_PRINT_SELECTION.csv

object_id | upstream_plate | upstream_name | decision | print_quantity | material | delivered_file | sha256 | note
2 | 1 | ankle_l_v1_脚踝左V1.stl | OMIT_OLD_VARIANT | 0 |  |  |  | 与FT选定踝座/轴承压盖互斥，不打印旧备选
4 | 1 | ankle_r_v1_脚踝右V1.stl | OMIT_OLD_VARIANT | 0 |  |  |  | 与FT选定踝座/轴承压盖互斥，不打印旧备选
6 | 4 | banana_pcb_locker_香蕉形PCB锁扣.stl | OMIT_ORIGINAL_ELECTRONICS | 0 |  |  |  | 原板卡/镜头/电池附件，不用于本RDK外挂路线
8 | 4 | bearing_roll_轴承滚轮.stl | OMIT_OLD_VARIANT | 0 |  |  |  | 与FT选定踝座/轴承压盖互斥，不打印旧备选
10 | 1 | bottom_head_shell_头部下壳.stl | PRINT_BODY | 1 | PLA | mechanical/body_parts/G04_010_bottom.stl | 29b384ae78656c39be5d2332b44f9d43478b63ed07e341a0db37880f407915dd | 本体基准；每个编号打印1件，左右同形副本也各1件
12 | 1 | foot_left_左脚.stl | PRINT_BODY | 1 | PLA | mechanical/body_parts/G03_012_foot.stl | cd0d65cddf70a6971d7c3cd34dca314331d8d59cf7bbe58fc60168e6569c9bf0 | 本体基准；每个编号打印1件，左右同形副本也各1件
14 | 1 | foot_right_右脚.stl | PRINT_BODY | 1 | PLA | mechanical/body_parts/G03_014_foot.stl | b3ee2d8b0cfa4b649fe3c1915bf0105082ff94b41e55b78bcbc8d3712ed16cf0 | 本体基准；每个编号打印1件，左右同形副本也各1件
16 | 4 | hip_l_髋部左.stl | PRINT_BODY | 1 | PLA | mechanical/body_parts/G01_016_hip.stl | b4c63884ef5ed529727a286f97323acbb5a5ecdc8fe1f9a785d78a67d0242f3f | 本体基准；每个编号打印1件，左右同形副本也各1件
18 | 4 | jaw_soft_软下巴.stl | OPTIONAL_SOFT_MOUTH | 0 | soft_material |  |  | 外观软嘴可选；本次不交付其切片，不能据此声称原型使用此软料
19 | 4 | hip_l_髋部左.stl | PRINT_BODY | 1 | PLA | mechanical/body_parts/G01_019_hip.stl | b4c63884ef5ed529727a286f97323acbb5a5ecdc8fe1f9a785d78a67d0242f3f | 本体基准；每个编号打印1件，左右同形副本也各1件
21 | 1 | jaw_下巴.stl | PRINT_BODY | 1 | PLA | mechanical/body_parts/G05_021_jaw.stl | 2b4f2177b57c03e4c9bfdcf196d3dbf732443af13ed2ba708fb1e5e669e4352e | 本体基准；每个编号打印1件，左右同形副本也各1件
23 | 3 | left_shell_左壳.stl | PRINT_BODY | 1 | PLA | mechanical/body_parts/G06_023_left.stl | 833a2c5554885749f98f699bb1d5349376e2638a1510f14b2dda0f3804612029 | 本体基准；每个编号打印1件，左右同形副本也各1件
25 | 2 | m12_lens_holder_M12镜头座.stl | OMIT_ORIGINAL_ELECTRONICS | 0 |  |  |  | 原板卡/镜头/电池附件，不用于本RDK外挂路线
27 | 4 | motor_support_电机支架.stl | PRINT_BODY | 1 | PLA | mechanical/body_parts/G01_027_motor.stl | b8e5a15fdc30b84780689ee3cb34b6ba173707e38a41c667d96da1d1df89b55e | 本体基准；每个编号打印1件，左右同形副本也各1件
29 | 4 | neck_pitch_颈部俯仰.stl | PRINT_BODY | 1 | PLA | mechanical/body_parts/G05_029_neck.stl | 88317bd6d319ef650319ae5910ad692e0d5ffb1ca845b8f1c2e6d21cfe1d1eb0 | 本体基准；每个编号打印1件，左右同形副本也各1件
31 | 4 | neck_颈部.stl | PRINT_BODY | 1 | PLA | mechanical/body_parts/G05_031_neck.stl | cbfee3eaf107aefdb65c7489b7e29af69184f0a7ead30a402851efd6f17d6a95 | 本体基准；每个编号打印1件，左右同形副本也各1件
32 | 4 | neck_颈部.stl | PRINT_BODY | 1 | PLA | mechanical/body_parts/G05_032_neck.stl | cbfee3eaf107aefdb65c7489b7e29af69184f0a7ead30a402851efd6f17d6a95 | 本体基准；每个编号打印1件，左右同形副本也各1件
34 | 3 | noenoeil_眼睛.stl | PRINT_BODY | 1 | PLA | mechanical/body_parts/G05_034_noenoeil.stl | 5bf78e2ec606f6d9a406e7f59986691fde21d177153f61d59104cbff192b4b88 | 本体基准；每个编号打印1件，左右同形副本也各1件
36 | 4 | power_support_电源支架.stl | OMIT_ORIGINAL_ELECTRONICS | 0 |  |  |  | 原板卡/镜头/电池附件，不用于本RDK外挂路线
38 | 3 | right_shell_右壳.stl | PRINT_BODY | 1 | PLA | mechanical/body_parts/G06_038_right.stl | 12f686efba44ab8b02ecd4719a389e04f48975ec746d90afc241f2cc522b953a | 本体基准；每个编号打印1件，左右同形副本也各1件
40 | 5 | rim_轮辋.stl | OMIT_ROLLER_VARIANT | 0 |  |  |  | 轮滑支架/轮毂/轮胎，本次双足路线不使用
42 | 1 | roller_blade_滚轮叶片.stl | OMIT_ROLLER_VARIANT | 0 |  |  |  | 轮滑支架/轮毂/轮胎，本次双足路线不使用
44 | 4 | soft_mouth_top_软嘴顶部.stl | OPTIONAL_SOFT_MOUTH | 0 | soft_material |  |  | 外观软嘴可选；本次不交付其切片，不能据此声称原型使用此软料
46 | 2 | sole_left_左脚底.stl | PRINT_TPU_SOLE | 1 | TPU95A_HF | mechanical/tpu_soles/G07_046_sole.stl | 3d99d0f9619f4579bc5bccbc6b9ca9f6de63a053f7f0752bb16ad2dfd9ba6459 | 本包已有左右脚底；替换硬脚底，勿重复打印PLA脚底
48 | 2 | sole_right_右脚底.stl | PRINT_TPU_SOLE | 1 | TPU95A_HF | mechanical/tpu_soles/G07_048_sole.stl | fa7fec159eccc8700023dafe5e7b7febfb28d46c2aac37f0c0b33e9799047eff | 本包已有左右脚底；替换硬脚底，勿重复打印PLA脚底
50 | 3 | top_head_shell_头部上壳.stl | PRINT_BODY | 1 | PLA | mechanical/body_parts/G04_050_top.stl | 9a6a512f455f80cfc53271d540ac13bda7742d00b7d66ffc9b16a2b6ea91ee1a | 本体基准；每个编号打印1件，左右同形副本也各1件
52 | 5 | trunk_base_躯干底座.stl | REPLACED_BY_R8A_L1 | 0 |  |  |  | 本机载配置用L1短根座替换052；两者不叠装
54 | 4 | yaw2roll_偏航转横滚.stl | PRINT_BODY | 1 | PLA | mechanical/body_parts/G01_054_yaw2roll.stl | 1337b0efa7b4148cd53ee755d01abf4c156d5f2ea9fb7f0f39909cc243d91552 | 本体基准；每个编号打印1件，左右同形副本也各1件
56 | 4 | face_part_面部零件.stp | PRINT_BODY | 1 | PLA | mechanical/body_parts/G04_056_face.stl | 0e97ce48034479d7e055eee9c7df3d9057546d3922dea0375fc7f78fce3d0e16 | 本体基准；每个编号打印1件，左右同形副本也各1件
58 | 5 | tire_轮胎.stl | OMIT_ROLLER_VARIANT | 0 |  |  |  | 轮滑支架/轮毂/轮胎，本次双足路线不使用
59 | 4 | yaw2roll_偏航转横滚.stl | PRINT_BODY | 1 | PLA | mechanical/body_parts/G01_059_yaw2roll.stl | 1337b0efa7b4148cd53ee755d01abf4c156d5f2ea9fb7f0f39909cc243d91552 | 本体基准；每个编号打印1件，左右同形副本也各1件
60 | 5 | rim_轮辋.stl | OMIT_ROLLER_VARIANT | 0 |  |  |  | 轮滑支架/轮毂/轮胎，本次双足路线不使用
61 | 5 | rim_轮辋.stl | OMIT_ROLLER_VARIANT | 0 |  |  |  | 轮滑支架/轮毂/轮胎，本次双足路线不使用
63 | 5 | 轴承12×6×3.STEP | OMIT_BEARING_MESH | 0 |  |  |  | 轮滑轴承占位，不用打印塑料代替金属轴承
64 | 1 | roller_blade_滚轮叶片.stl | OMIT_ROLLER_VARIANT | 0 |  |  |  | 轮滑支架/轮毂/轮胎，本次双足路线不使用
65 | 4 | bearing_roll_轴承滚轮.stl | OMIT_OLD_VARIANT | 0 |  |  |  | 与FT选定踝座/轴承压盖互斥，不打印旧备选
66 | 5 | rim_轮辋.stl | OMIT_ROLLER_VARIANT | 0 |  |  |  | 轮滑支架/轮毂/轮胎，本次双足路线不使用
67 | 5 | 轴承12×6×3.STEP | OMIT_BEARING_MESH | 0 |  |  |  | 轮滑轴承占位，不用打印塑料代替金属轴承
69 | 1 | ankle_right脚踝右.STEP | PRINT_BODY | 1 | PLA | mechanical/body_parts/G02_069_ankle.stl | 8997a3770786349c34bafe214cb1c6d70c3211db9163e317375f15e3fb43c838 | 本体基准；每个编号打印1件，左右同形副本也各1件
71 | 1 | ankle_left_脚踝左.STEP | PRINT_BODY | 1 | PLA | mechanical/body_parts/G02_071_ankle.stl | 4d630e65a5726eb38df866a58ca33b3cca600e9859ce4d790347e0a55a062164 | 本体基准；每个编号打印1件，左右同形副本也各1件
73 | 3 | right_upper_leg_右上腿-FT.STEP | PRINT_BODY | 1 | PLA | mechanical/body_parts/G02_073_right.stl | 85268943905347f716574fd30dd7d4d29e93f251a09e51f7d2d003a903de07fb | 本体基准；每个编号打印1件，左右同形副本也各1件
75 | 3 | left_upper_leg_左上腿-FT.STEP | PRINT_BODY | 1 | PLA | mechanical/body_parts/G02_075_left.stl | e7cf801974e7b0d82a2df677d5cfe0deae65f12d98b99efb6ac7c105b29ef261 | 本体基准；每个编号打印1件，左右同形副本也各1件
77 | 5 | 01-upper_leg_rigidity_plate_上腿加固板-FT.STEP | PRINT_BODY | 1 | PLA | mechanical/body_parts/G02_077_01-upper.stl | edbb7de036c43c9c81a96048e19e82e5c13e8865e00d47f8045b517139679c38 | 本体基准；每个编号打印1件，左右同形副本也各1件
78 | 5 | 01-upper_leg_rigidity_plate_上腿加固板-FT.STEP | PRINT_BODY | 1 | PLA | mechanical/body_parts/G02_078_01-upper.stl | edbb7de036c43c9c81a96048e19e82e5c13e8865e00d47f8045b517139679c38 | 本体基准；每个编号打印1件，左右同形副本也各1件
80 | 4 | 99-yaw_roll_motion_偏航横滚运动-F.STEP | PRINT_BODY | 1 | PLA | mechanical/body_parts/G05_080_99-yaw.stl | 3a123e6a56c2b02b65d8aacf7f36e65ace577aeacd17ddd33f3b50cea116e506 | 本体基准；每个编号打印1件，左右同形副本也各1件
82 | 5 | bearing_roll_轴承滚轮-FT.STEP | PRINT_BODY | 1 | PLA | mechanical/body_parts/G01_082_bearing.stl | 219576861fc9debe5e40e60ef8de4c570ec3dea3cea7f79f7265f842710a8147 | 本体基准；每个编号打印1件，左右同形副本也各1件
84 | 4 | leg_腿部-FT.STEP | PRINT_BODY | 1 | PLA | mechanical/body_parts/G02_084_leg.stl | 69e4438d39b84fc6d39c7fa6d85f9aab078e5ce0f20a859322bbbfaaee335b89 | 本体基准；每个编号打印1件，左右同形副本也各1件
85 | 5 | bearing_roll_轴承滚轮-FT.STEP | PRINT_BODY | 1 | PLA | mechanical/body_parts/G01_085_bearing.stl | 219576861fc9debe5e40e60ef8de4c570ec3dea3cea7f79f7265f842710a8147 | 本体基准；每个编号打印1件，左右同形副本也各1件
86 | 4 | leg_腿部-FT.STEP | PRINT_BODY | 1 | PLA | mechanical/body_parts/G02_086_leg.stl | 69e4438d39b84fc6d39c7fa6d85f9aab078e5ce0f20a859322bbbfaaee335b89 | 本体基准；每个编号打印1件，左右同形副本也各1件
87 | 5 | tire_轮胎.stl | OMIT_ROLLER_VARIANT | 0 |  |  |  | 轮滑支架/轮毂/轮胎，本次双足路线不使用
88 | 5 | tire_轮胎.stl | OMIT_ROLLER_VARIANT | 0 |  |  |  | 轮滑支架/轮毂/轮胎，本次双足路线不使用
89 | 5 | tire_轮胎.stl | OMIT_ROLLER_VARIANT | 0 |  |  |  | 轮滑支架/轮毂/轮胎，本次双足路线不使用
