Xiaomiju-x/rdk-x5-microduck/mechanical/body_parts/G03_014_foot.stl

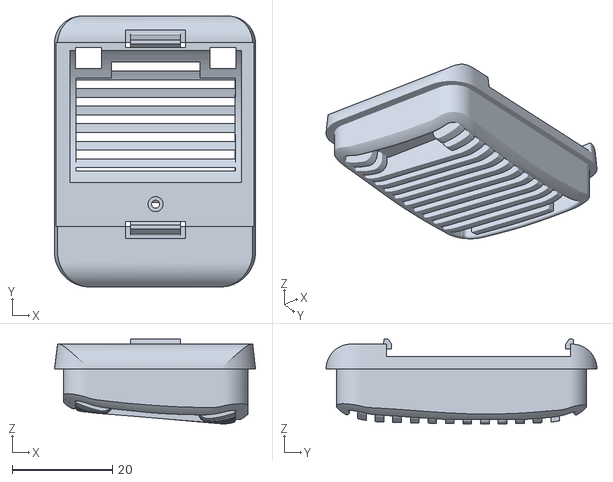
[picture p32: CAD file, 2026-10-27]
mechanical/body_parts/G03_014_foot.stl
40.1 x 54.0 x 16.9
