Xiaomiju-x/rdk-x5-microduck/mechanical/cad/R8A_print_parts.step

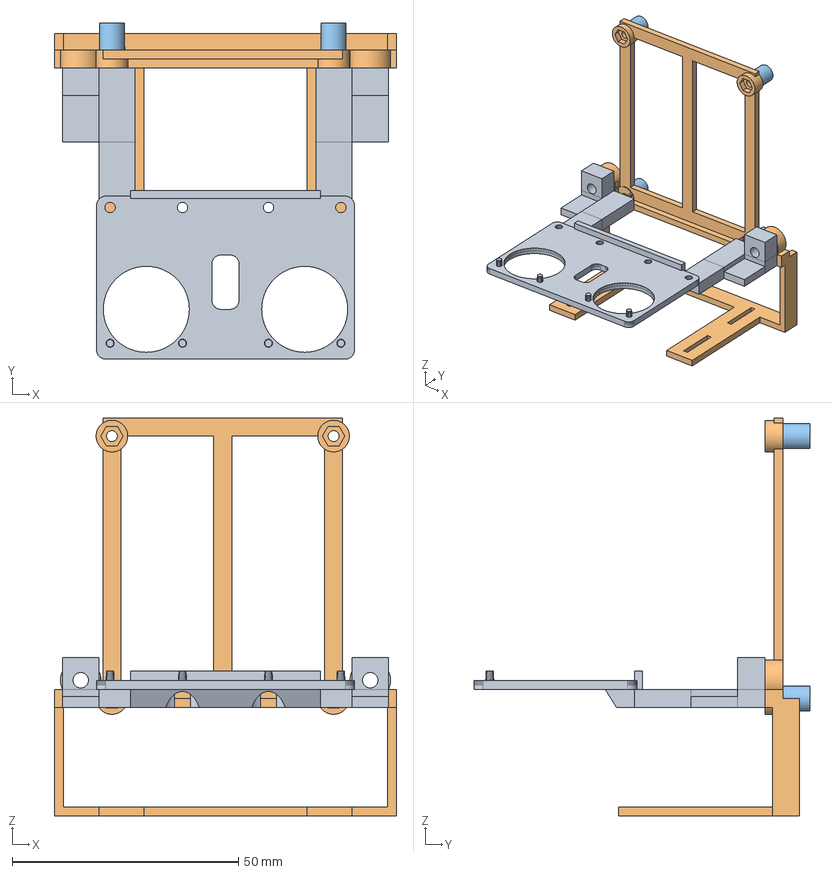
[picture p33: CAD file, 2026-10-26]
mechanical/cad/R8A_print_parts.step
75.6 x 74.3 x 88.0 mm
