Xiaomiju-x/rdk-x5-microduck/mechanical/print_projects/R8A_SIX_PARTS_P1S_PLA.3mf

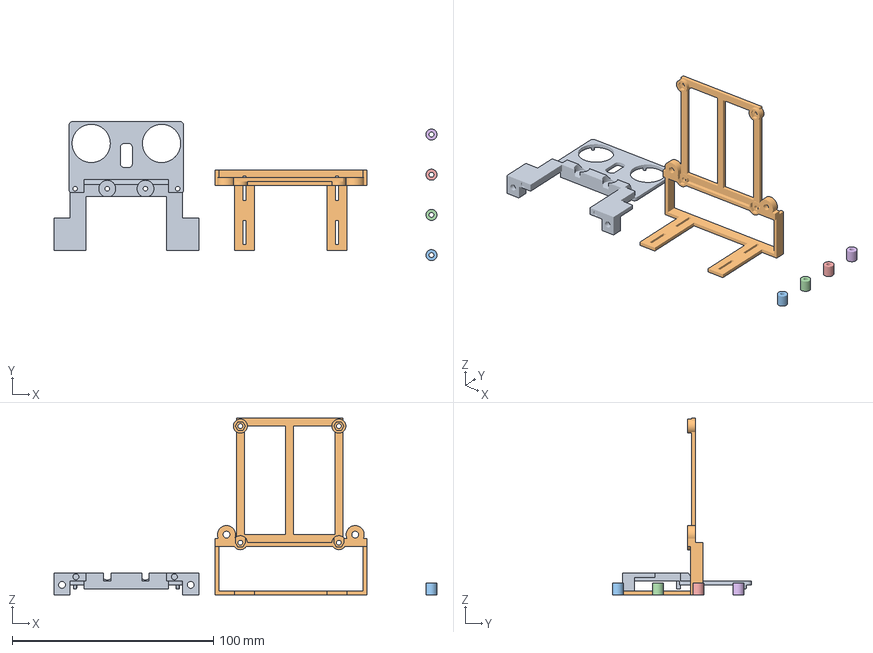
[picture p34: CAD file, 2026-10-26]
mechanical/print_projects/R8A_SIX_PARTS_P1S_PLA.3mf
190.5 x 69.3 x 88.0 mm
L1_R8_short_FT_root
L2_R8_flat_battery_portrait_X5
S1_R8_PCB_spacer_6mm x 4
