Xiaomiju-x/rdk-x5-microduck/mechanical/r8a_parts/L2_R8_flat_battery_portrait_X5.step

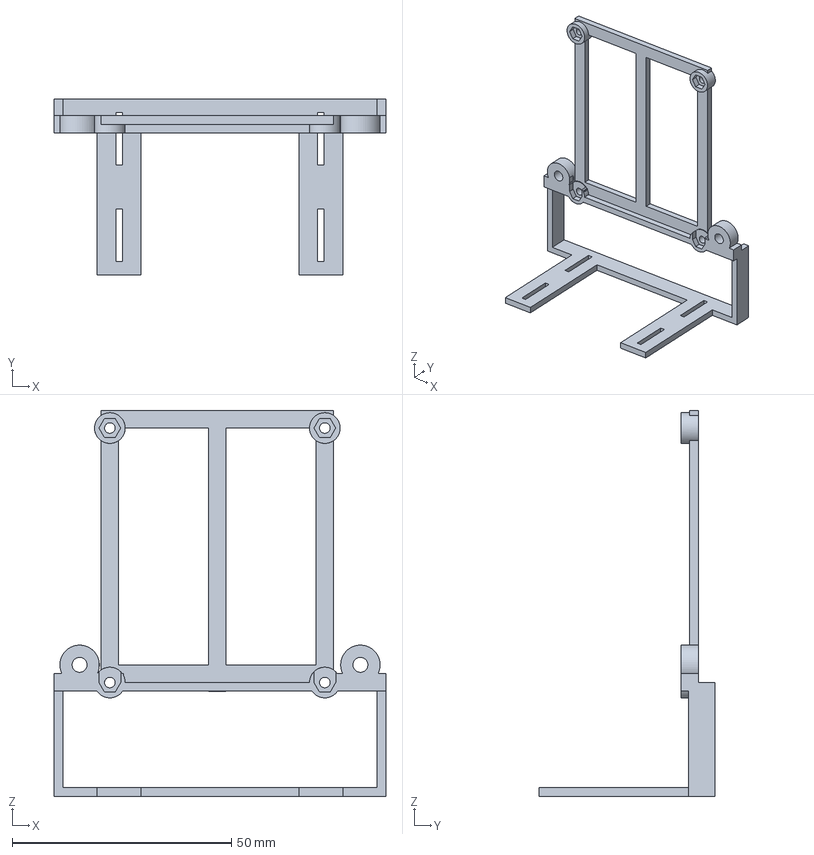
[picture p35: CAD file, 2026-10-26]
mechanical/r8a_parts/L2_R8_flat_battery_portrait_X5.step
75.6 x 40.0 x 88.0 mm
