Xiaomiju-x/rdk-x5-microduck/mechanical/tpu_soles/G07_046_sole.stl

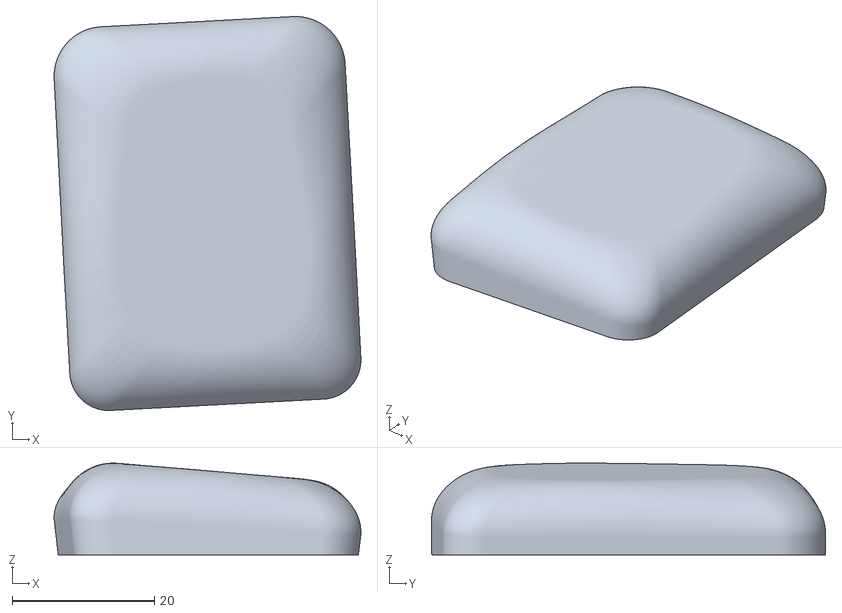
[picture p36: CAD file, 2026-10-26]
mechanical/tpu_soles/G07_046_sole.stl
43.2 x 55.5 x 12.9
