Xiaomiju-x/rdk-x5-microduck/projects/pumpkin-duck/mechanical/mask/P08_LED_keeper_left.step

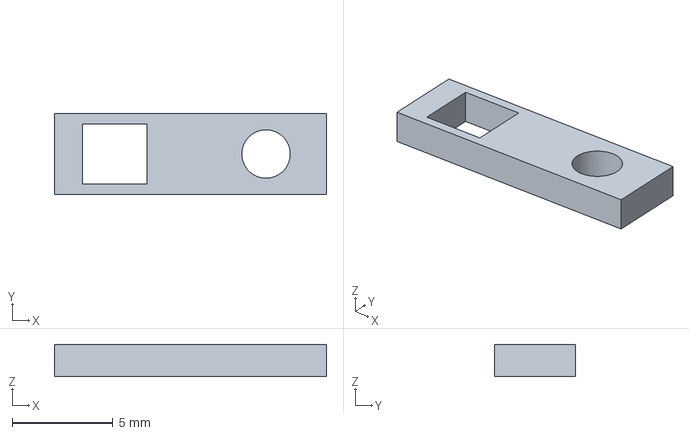
[picture p37: CAD file, 2026-10-30]
projects/pumpkin-duck/mechanical/mask/P08_LED_keeper_left.step
13.5 x 4.00 x 1.60 mm
