Xiaomiju-x/rdk-x5-microduck/simulation/model/meshes/link_00.stl

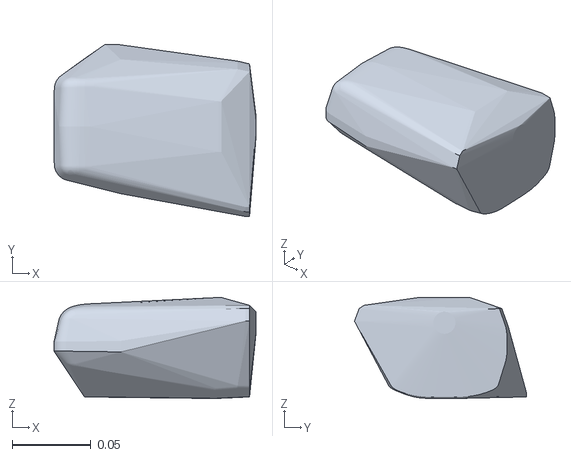
[picture p38: CAD file, 2026-10-27]
simulation/model/meshes/link_00.stl
0.128 x 0.109 x 0.064
