Xiaomiju-x/rdk-x5-microduck/mechanical/print_projects/RDK_FT_LEFT_RIGHT_SOLES_P1S_TPU95AHF.3mf

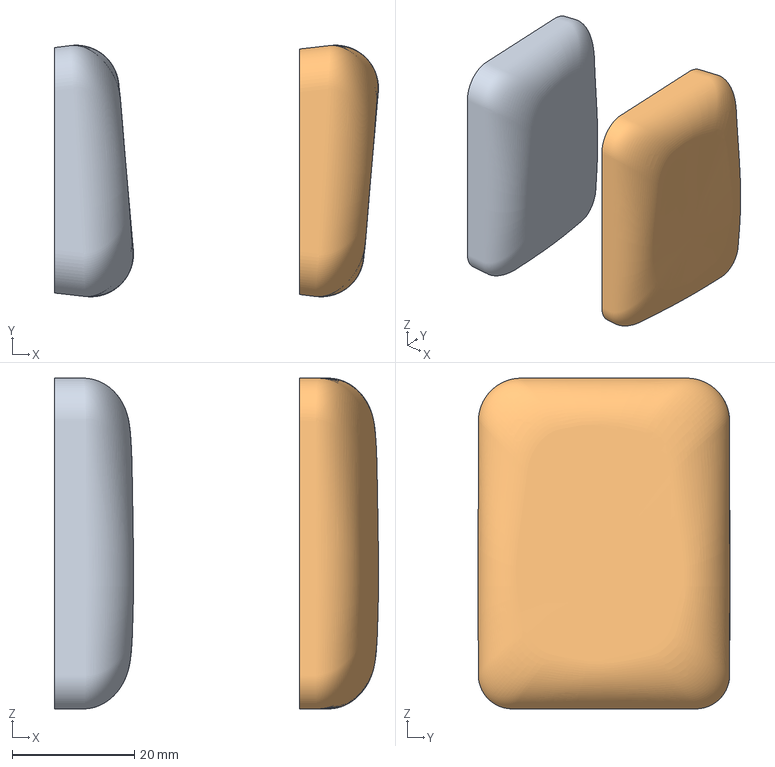
[picture p40: CAD file, 2026-10-26]
mechanical/print_projects/RDK_FT_LEFT_RIGHT_SOLES_P1S_TPU95AHF.3mf
52.9 x 41.1 x 54.0 mm
046_LEFT_SOLE
048_RIGHT_SOLE
