Xiaomiju-x/rdk-x5-microduck/mechanical/r8a_parts/L1_R8_short_FT_root.step

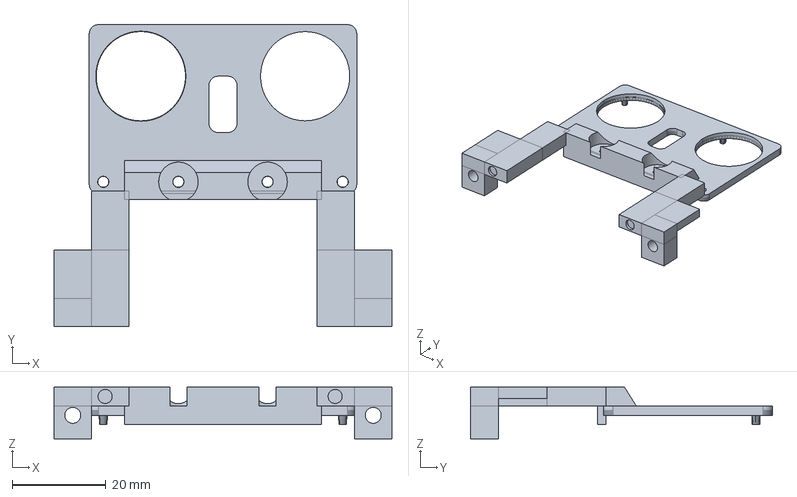
[picture p41: CAD file, 2026-10-26]
mechanical/r8a_parts/L1_R8_short_FT_root.step
72.0 x 64.3 x 11.0 mm
