Xiaomiju-x/rdk-x5-microduck/mechanical/tpu_soles/G07_048_sole.stl

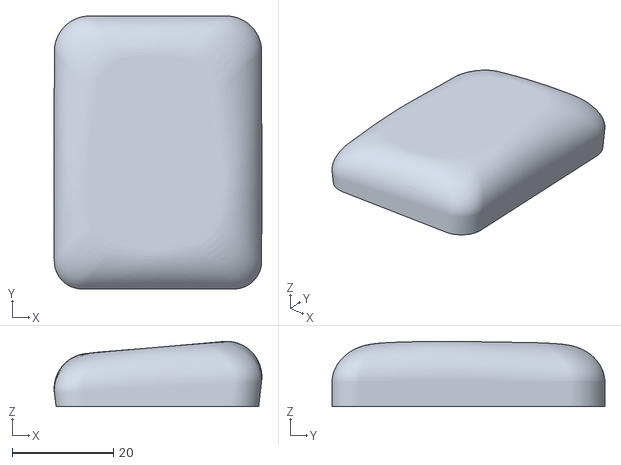
[picture p42: CAD file, 2026-10-26]
mechanical/tpu_soles/G07_048_sole.stl
41.1 x 54.0 x 12.9
