Xiaomiju-x/rdk-x5-microduck/projects/pumpkin-duck/mechanical/mask/P04_pumpkin_imp_shell.step

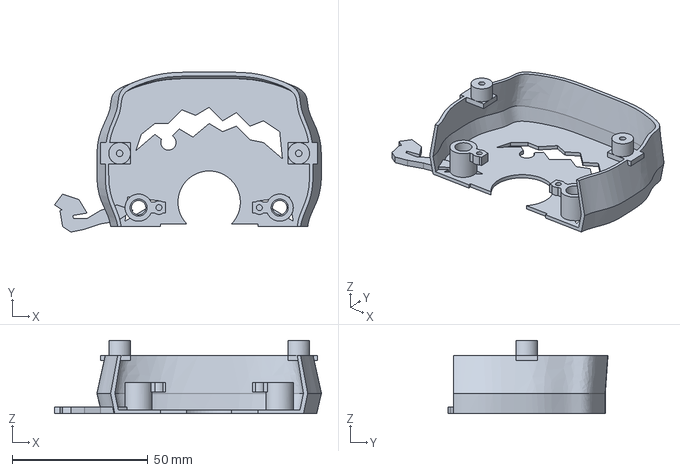
[picture p43: CAD file, 2026-10-30]
projects/pumpkin-duck/mechanical/mask/P04_pumpkin_imp_shell.step
98.4 x 59.0 x 27.0 mm
