Xiaomiju-x/rdk-x5-microduck/simulation/model/meshes/link_09.stl

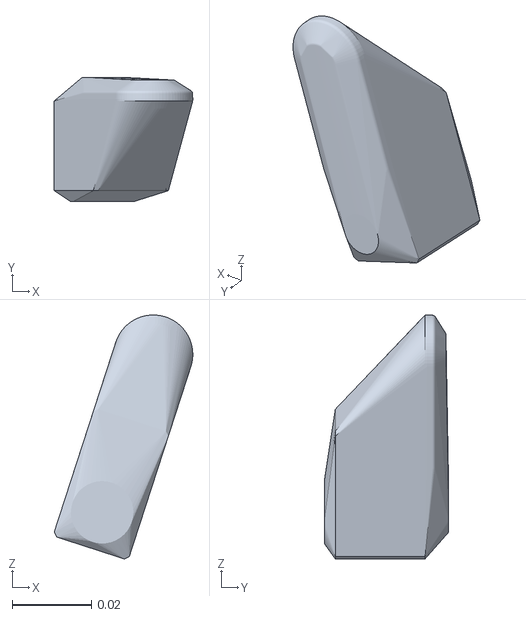
[picture p44: CAD file, 2026-10-27]
simulation/model/meshes/link_09.stl
0.0351 x 0.0315 x 0.0617
