Xiaomiju-x/rdk-x5-microduck/mechanical/body_parts/G06_038_right.stl

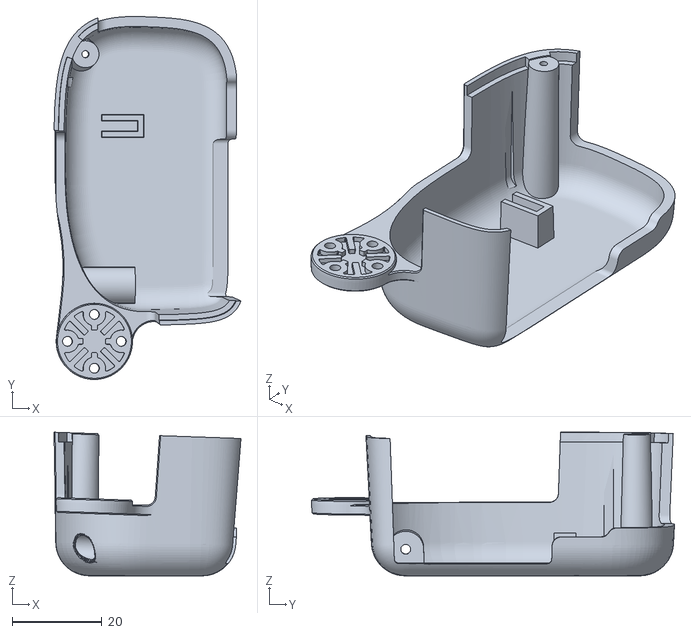
[picture p45: CAD file, 2026-10-27]
mechanical/body_parts/G06_038_right.stl
41.7 x 80.9 x 32.0
