Xiaomiju-x/rdk-x5-microduck/mechanical/r8a_parts/S1_R8_PCB_spacer_6mm.step

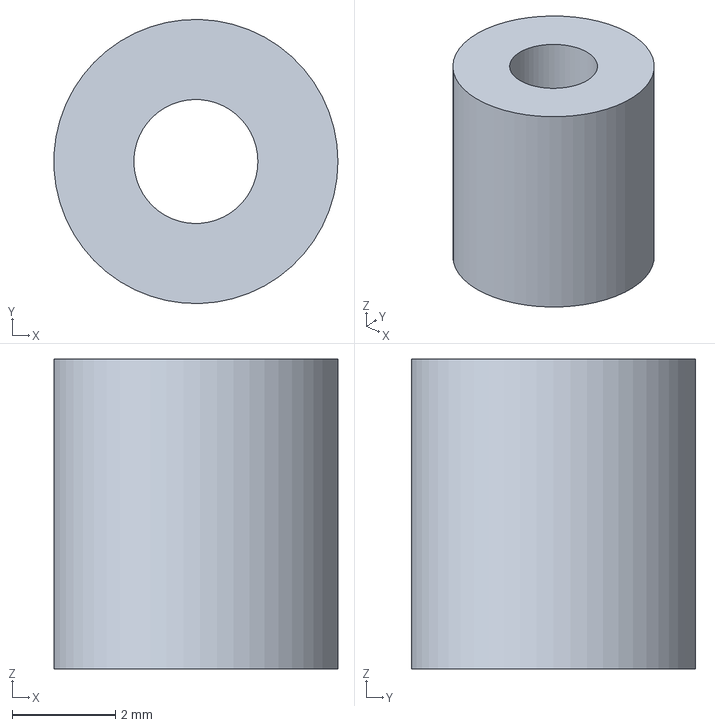
[picture p46: CAD file, 2026-10-26]
mechanical/r8a_parts/S1_R8_PCB_spacer_6mm.step
5.50 x 5.50 x 6.00 mm
