Xiaomiju-x/rdk-x5-microduck/projects/pumpkin-duck/mechanical/mask/P03_chest_skeleton.step

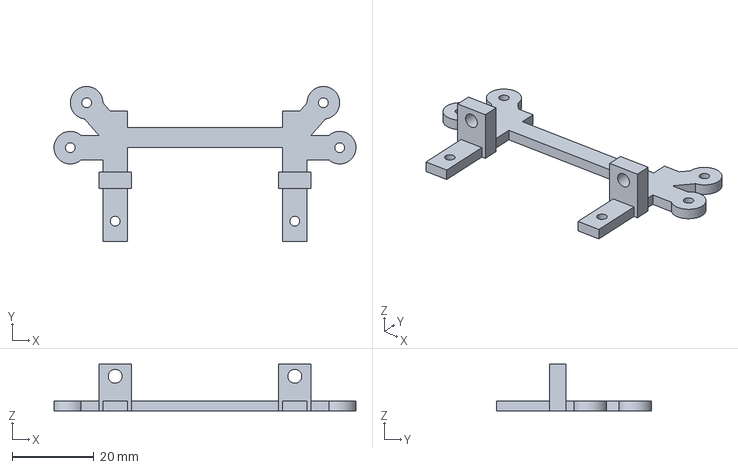
[picture p47: CAD file, 2026-10-30]
projects/pumpkin-duck/mechanical/mask/P03_chest_skeleton.step
74.0 x 38.0 x 11.5 mm
