Xiaomiju-x/rdk-x5-microduck/simulation/model/meshes/link_15.stl

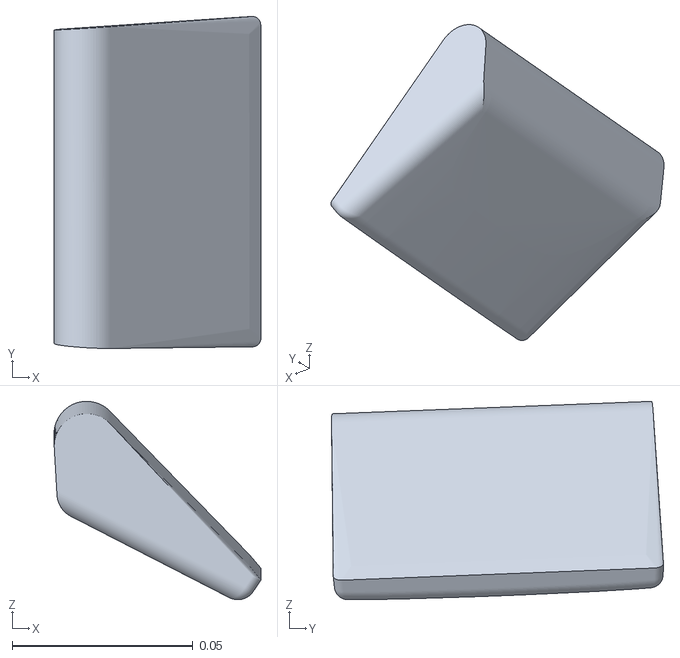
[picture p48: CAD file, 2026-10-27]
simulation/model/meshes/link_15.stl
0.0572 x 0.0918 x 0.0549
