Xiaomiju-x/rdk-x5-microduck/mechanical/body_parts/G02_075_left.stl

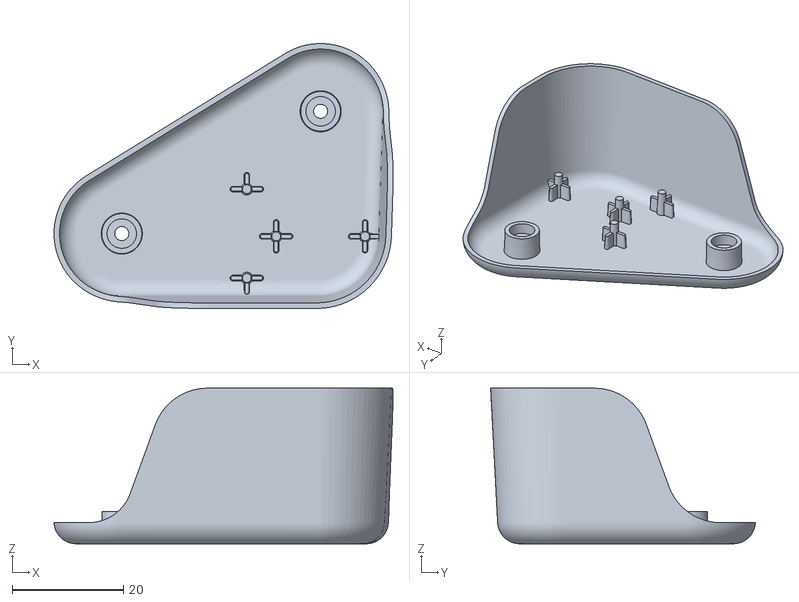
[picture p49: CAD file, 2026-10-27]
mechanical/body_parts/G02_075_left.stl
61.0 x 47.7 x 28.0
