Xiaomiju-x/rdk-x5-microduck/projects/pumpkin-duck/mechanical/mask/P00_fit_gauge.step

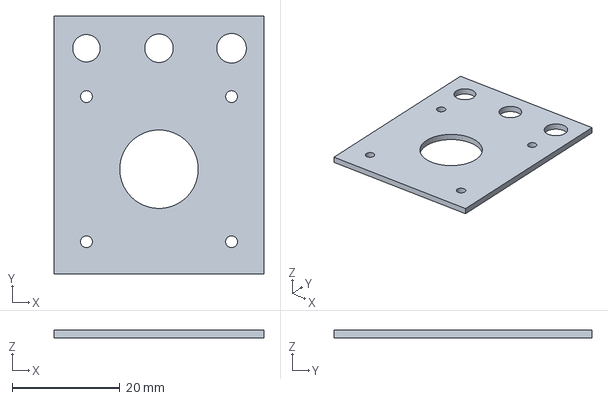
[picture p50: CAD file, 2026-10-30]
projects/pumpkin-duck/mechanical/mask/P00_fit_gauge.step
39.0 x 48.0 x 1.40 mm
