Xiaomiju-x/rdk-x5-microduck/simulation/model/meshes/link_01.stl

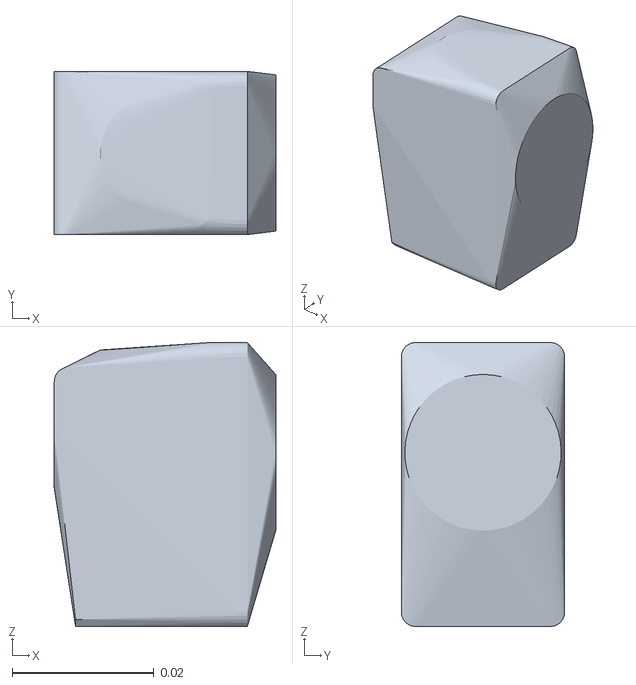
[picture p51: CAD file, 2026-10-27]
simulation/model/meshes/link_01.stl
0.0312 x 0.023 x 0.04
