Xiaomiju-x/rdk-x5-microduck/mechanical/body_parts/G04_056_face.stl

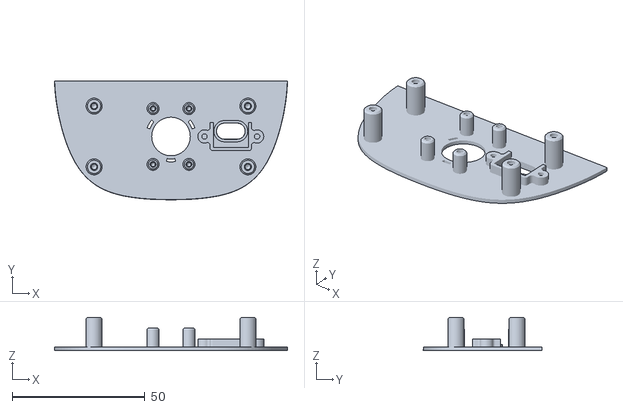
[picture p52: CAD file, 2026-10-27]
mechanical/body_parts/G04_056_face.stl
87.7 x 44.6 x 12.5
