Xiaomiju-x/rdk-x5-microduck/projects/pumpkin-duck/mechanical/mask/P01_front_collar_R1c_closed_holes.step

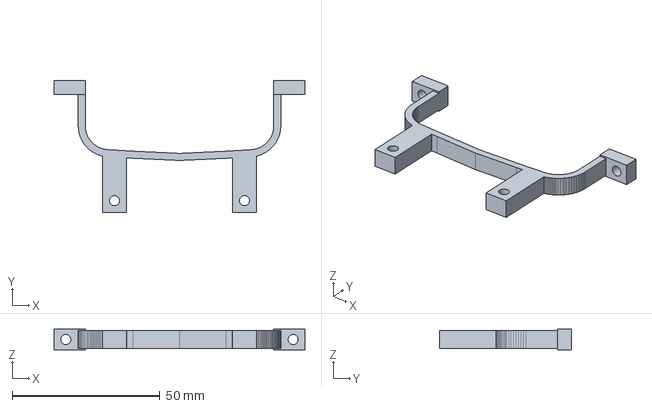
[picture p53: CAD file, 2026-10-30]
projects/pumpkin-duck/mechanical/mask/P01_front_collar_R1c_closed_holes.step
85.0 x 44.7 x 7.00 mm
