Xiaomiju-x/rdk-x5-microduck/simulation/model/meshes/link_14.stl

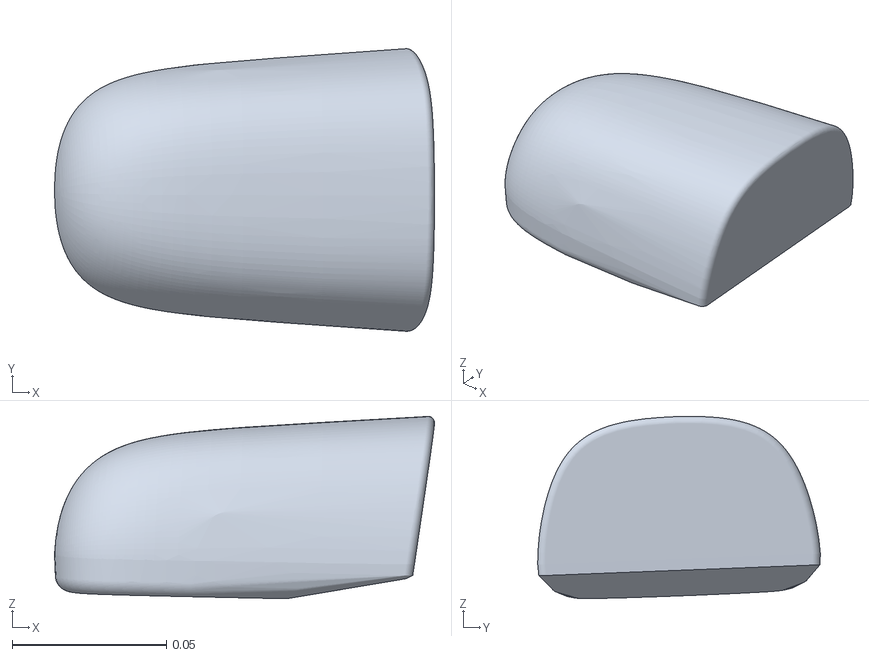
[picture p54: CAD file, 2026-10-27]
simulation/model/meshes/link_14.stl
0.123 x 0.0917 x 0.0591
