Xiaomiju-x/rdk-x5-microduck/mechanical/body_parts/G06_023_left.stl

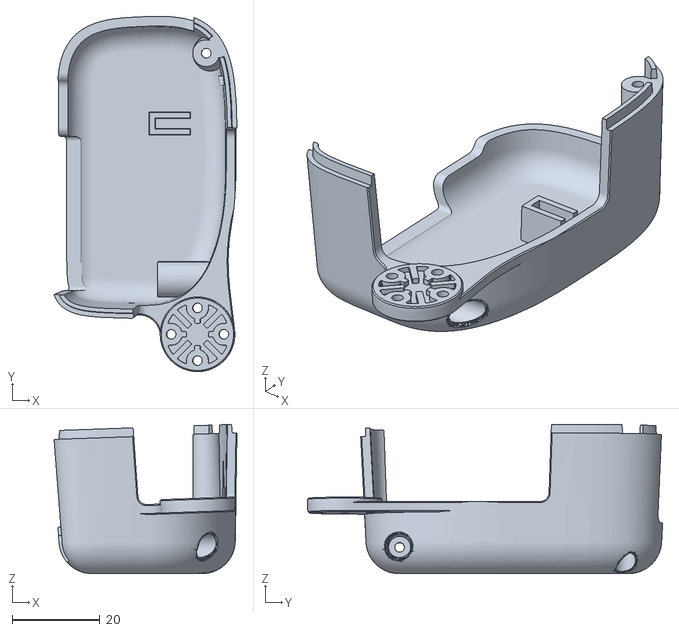
[picture p55: CAD file, 2026-10-27]
mechanical/body_parts/G06_023_left.stl
41.7 x 80.9 x 34.0
