Xiaomiju-x/rdk-x5-microduck/projects/pumpkin-duck/mechanical/mask/P06_CI1302_R1b_flat_foam_plate.step

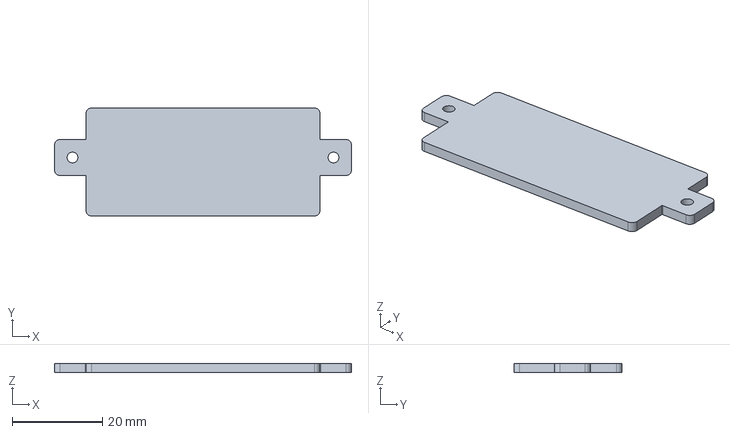
[picture p56: CAD file, 2026-10-30]
projects/pumpkin-duck/mechanical/mask/P06_CI1302_R1b_flat_foam_plate.step
66.0 x 24.0 x 2.00 mm
