Xiaomiju-x/rdk-x5-microduck/simulation/model/meshes/link_07.stl

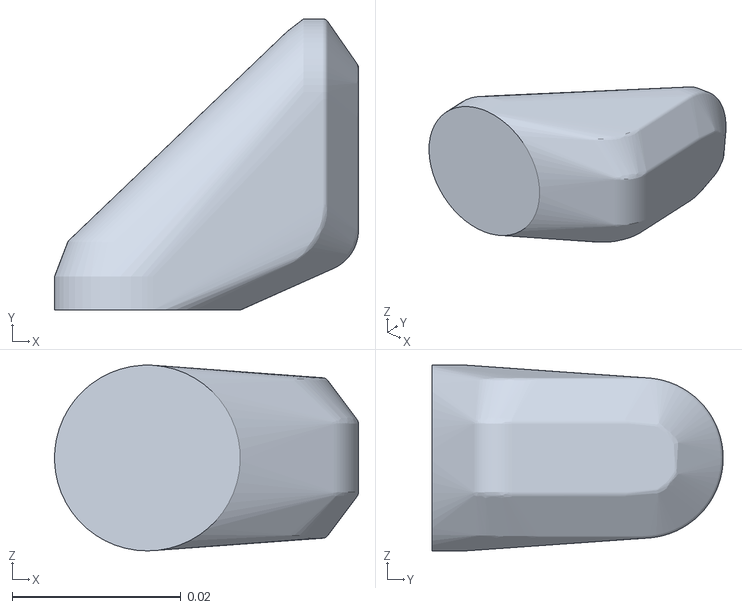
[picture p57: CAD file, 2026-10-27]
simulation/model/meshes/link_07.stl
0.036 x 0.0345 x 0.022
