Xiaomiju-x/rdk-x5-microduck/mechanical/body_parts/G01_054_yaw2roll.stl

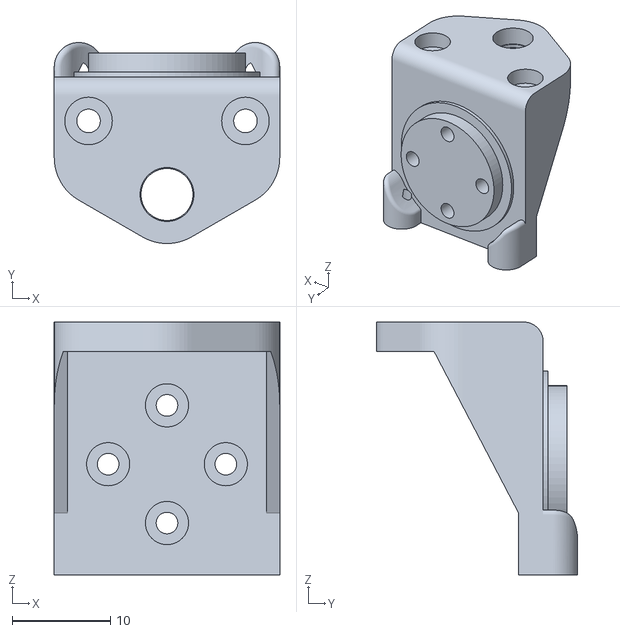
[picture p58: CAD file, 2026-10-27]
mechanical/body_parts/G01_054_yaw2roll.stl
23.0 x 20.5 x 25.8
