Xiaomiju-x/rdk-x5-microduck/projects/pumpkin-duck/mechanical/mask/P05_OV2710_camera_cradle_R1a_header_open.step

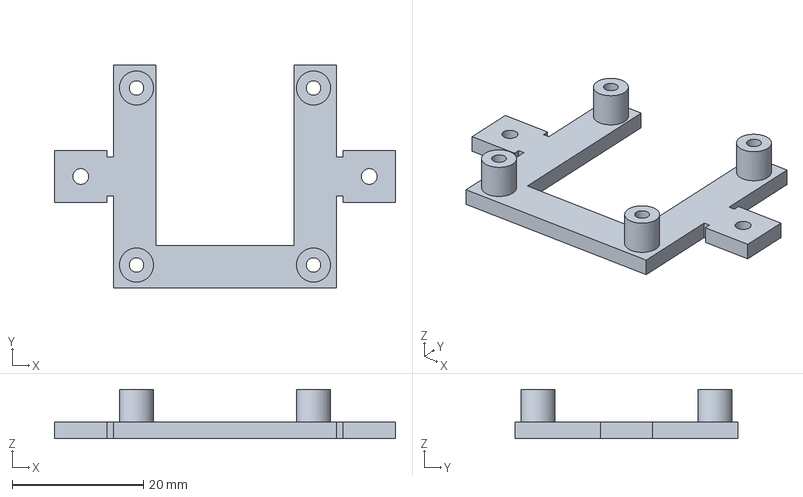
[picture p59: CAD file, 2026-10-30]
projects/pumpkin-duck/mechanical/mask/P05_OV2710_camera_cradle_R1a_header_open.step
52.0 x 34.0 x 7.50 mm
