Xiaomiju-x/rdk-x5-microduck/simulation/model/meshes/link_12.stl

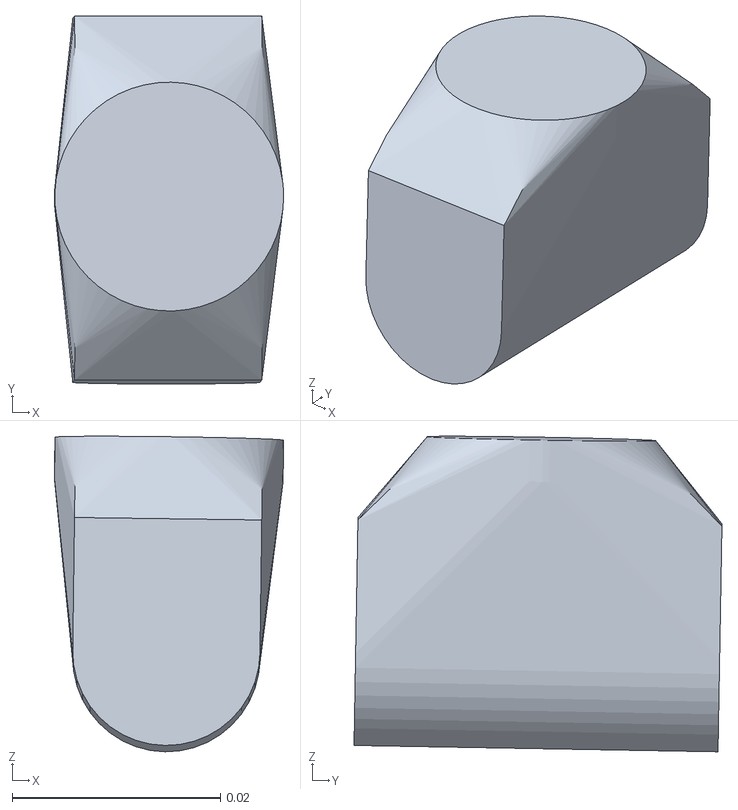
[picture p60: CAD file, 2026-10-27]
simulation/model/meshes/link_12.stl
0.022 x 0.0354 x 0.0303
