Xiaomiju-x/rdk-x5-microduck/mechanical/body_parts/G04_010_bottom.stl

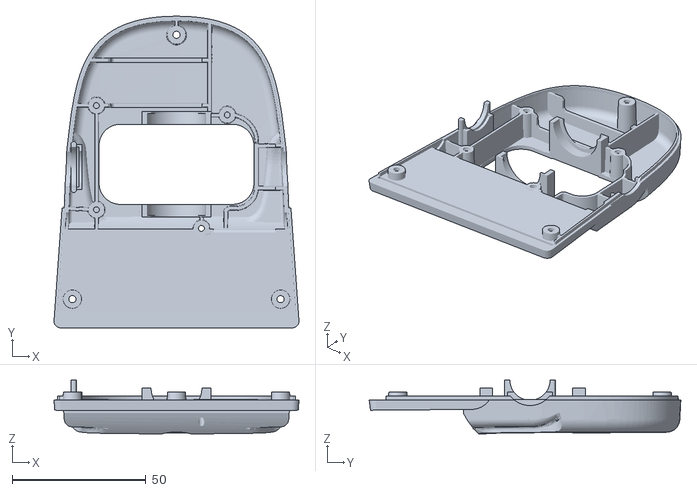
[picture p61: CAD file, 2026-10-27]
mechanical/body_parts/G04_010_bottom.stl
91.8 x 116.7 x 20.1
