Xiaomiju-x/rdk-x5-microduck/simulation/model/meshes/link_08.stl

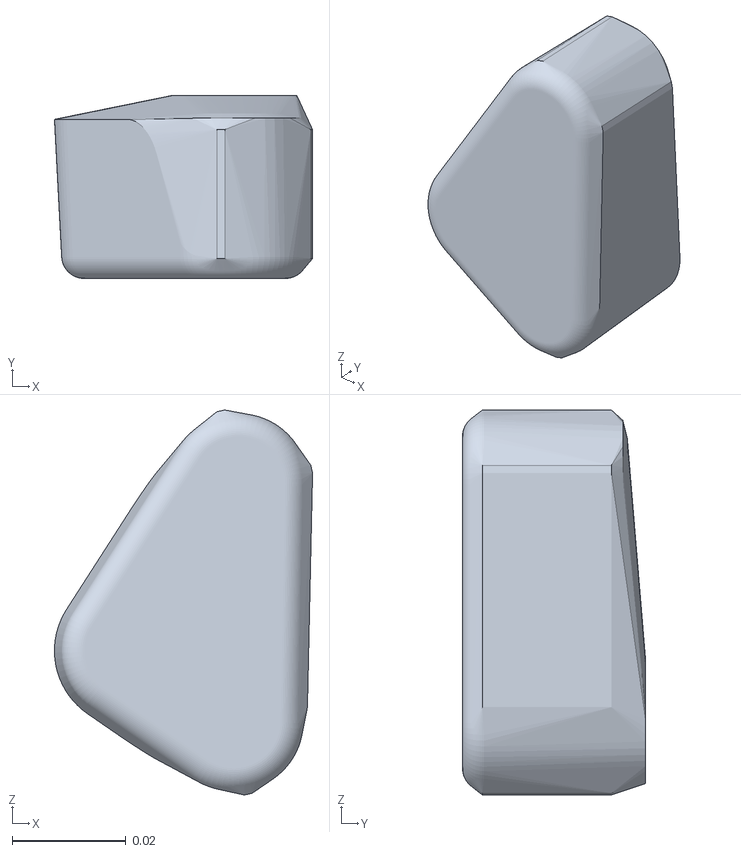
[picture p62: CAD file, 2026-10-27]
simulation/model/meshes/link_08.stl
0.0454 x 0.0322 x 0.0677
