Xiaomiju-x/rdk-x5-microduck/mechanical/body_parts/G01_016_hip.stl

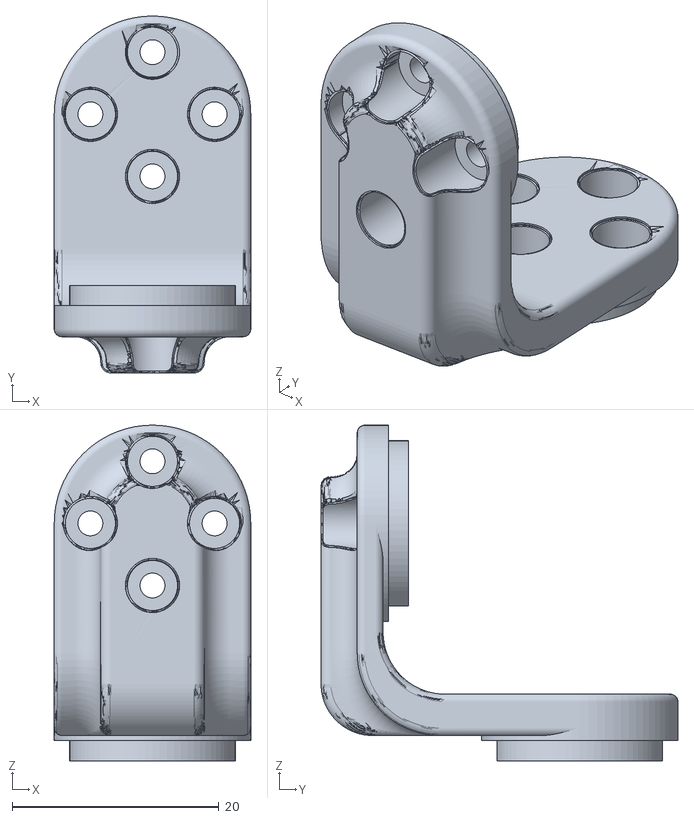
[picture p63: CAD file, 2026-10-27]
mechanical/body_parts/G01_016_hip.stl
19.0 x 34.5 x 32.5
