Xiaomiju-x/rdk-x5-microduck/projects/pumpkin-duck/mechanical/mask/P02_rear_collar.step

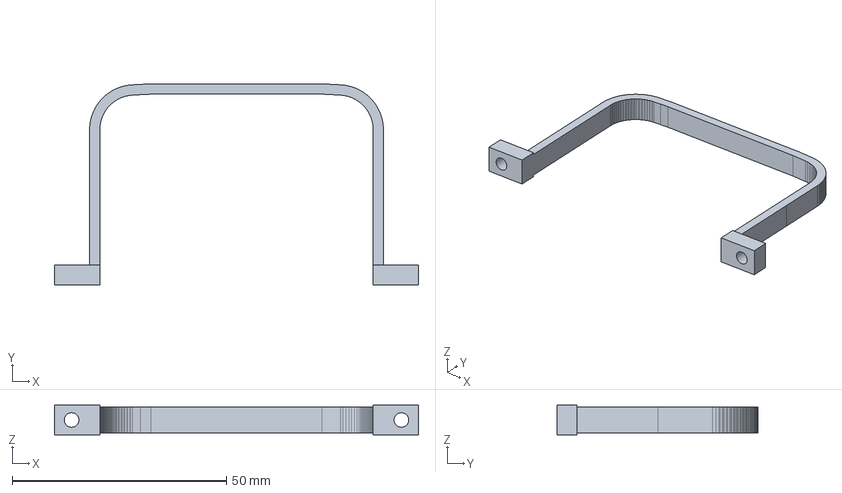
[picture p64: CAD file, 2026-10-30]
projects/pumpkin-duck/mechanical/mask/P02_rear_collar.step
85.0 x 47.0 x 7.00 mm
