Xiaomiju-x/rdk-x5-microduck/simulation/model/meshes/link_10.stl

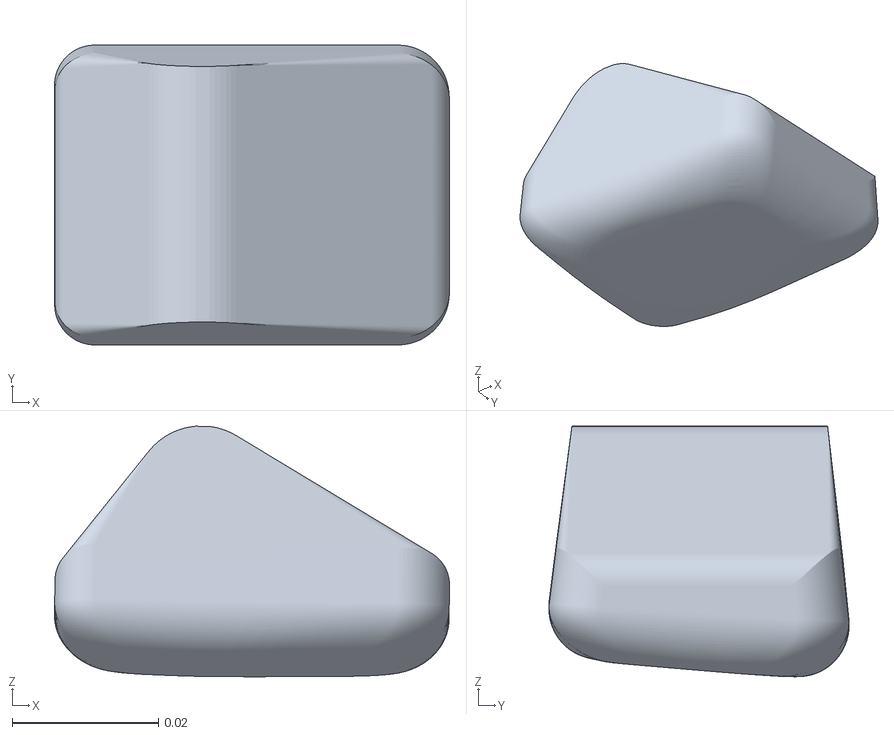
[picture p65: CAD file, 2026-10-27]
simulation/model/meshes/link_10.stl
0.0541 x 0.0411 x 0.0343
