Xiaomiju-x/rdk-x5-microduck/mechanical/body_parts/G05_021_jaw.stl

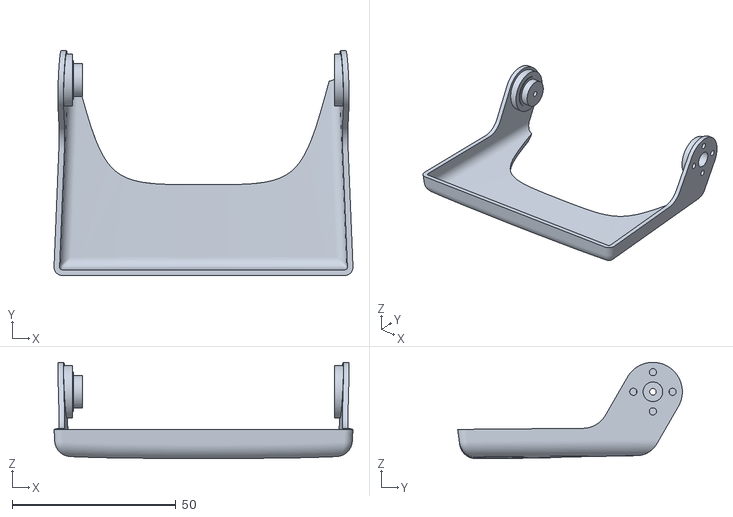
[picture p66: CAD file, 2026-10-27]
mechanical/body_parts/G05_021_jaw.stl
91.4 x 68.7 x 29.4
