Xiaomiju-x/rdk-x5-microduck/mechanical/body_parts/G05_080_99-yaw.stl

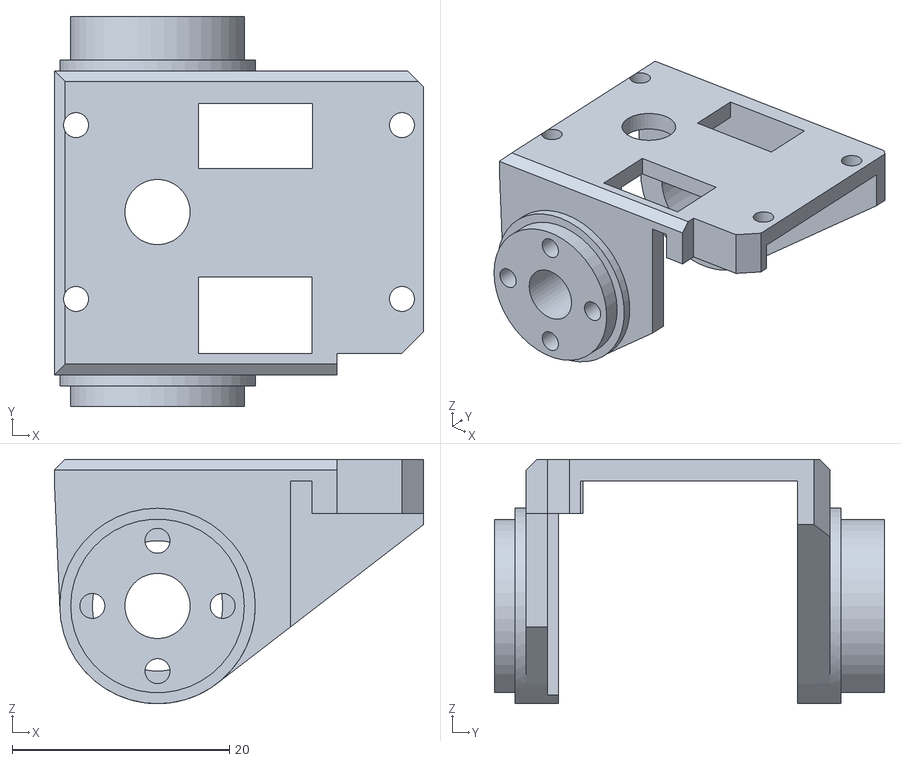
[picture p67: CAD file, 2026-10-27]
mechanical/body_parts/G05_080_99-yaw.stl
34.0 x 35.9 x 22.5
