Xiaomiju-x/rdk-x5-microduck/simulation/model/meshes/link_05.stl

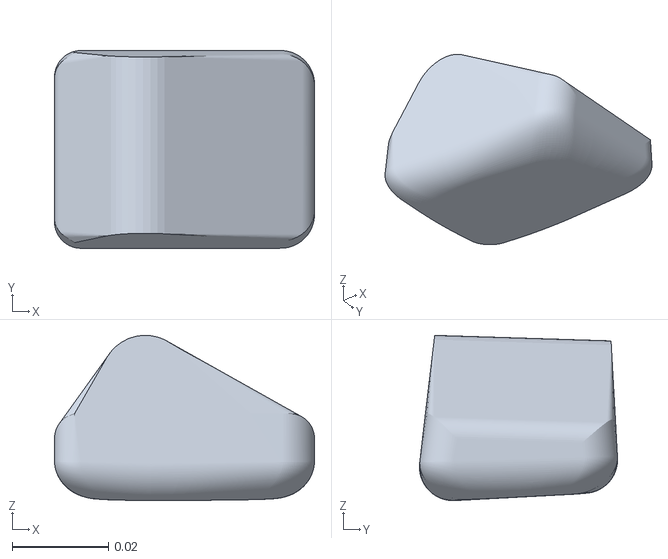
[picture p68: CAD file, 2026-10-27]
simulation/model/meshes/link_05.stl
0.054 x 0.0412 x 0.0343
