Xiaomiju-x/rdk-x5-microduck/mechanical/body_parts/G04_050_top.stl

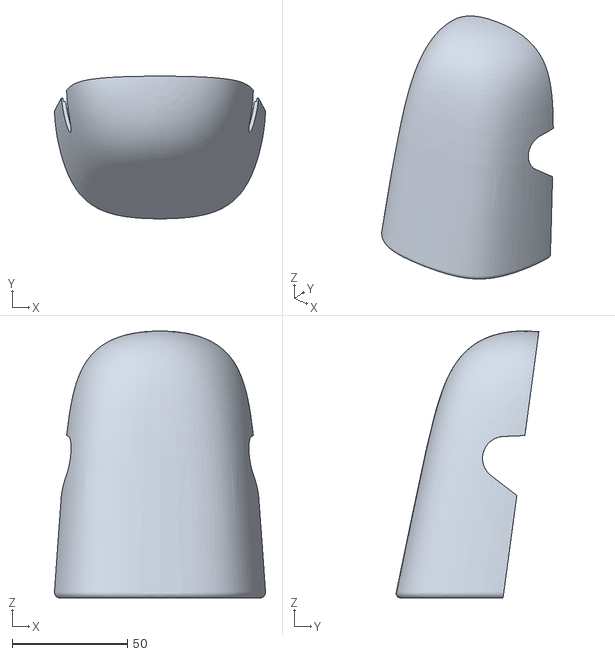
[picture p69: CAD file, 2026-10-27]
mechanical/body_parts/G04_050_top.stl
91.8 x 62.0 x 116.0
