Xiaomiju-x/rdk-x5-microduck/simulation/model/meshes/link_04.stl

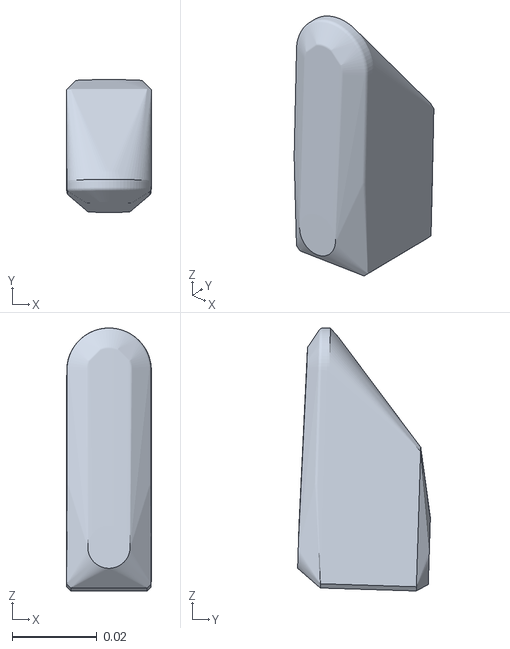
[picture p70: CAD file, 2026-10-27]
simulation/model/meshes/link_04.stl
0.02 x 0.0314 x 0.0622
