Xiaomiju-x/rdk-x5-microduck/mechanical/body_parts/G02_069_ankle.stl

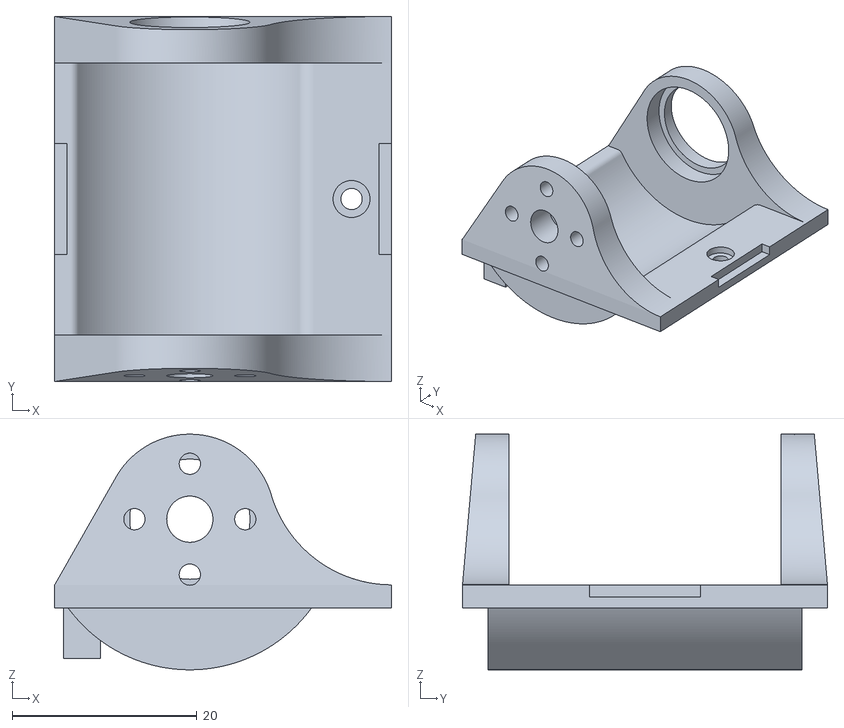
[picture p71: CAD file, 2026-10-27]
mechanical/body_parts/G02_069_ankle.stl
36.5 x 39.5 x 25.5
