Xiaomiju-x/rdk-x5-microduck/simulation/model/meshes/link_03.stl

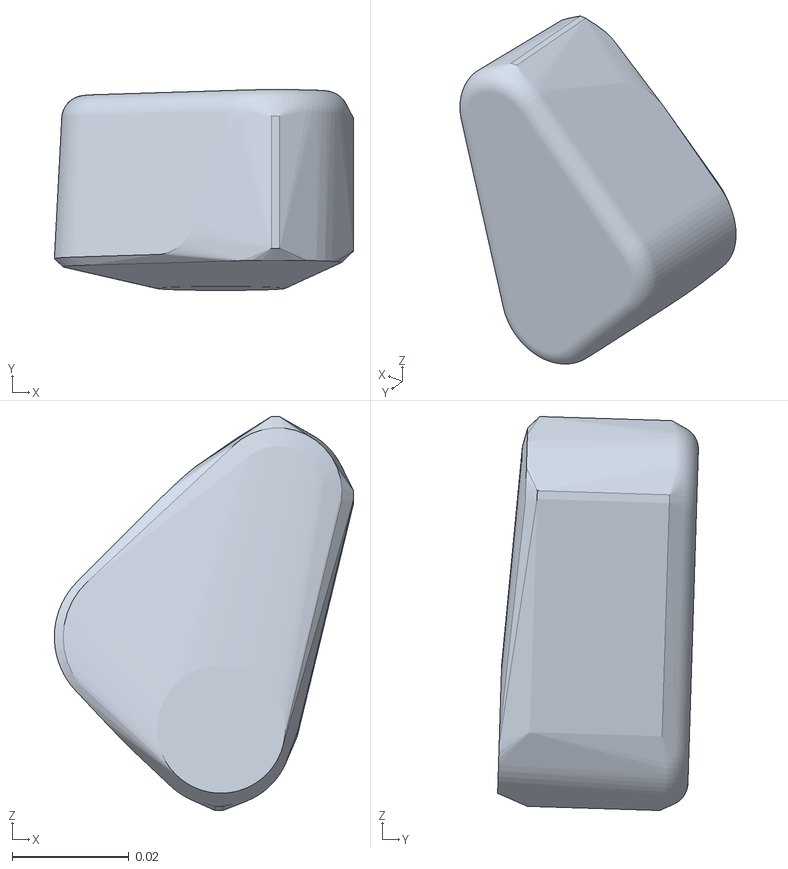
[picture p72: CAD file, 2026-10-27]
simulation/model/meshes/link_03.stl
0.0514 x 0.0345 x 0.0676
