Xiaomiju-x/rdk-x5-microduck/mechanical/body_parts/G05_034_noenoeil.stl

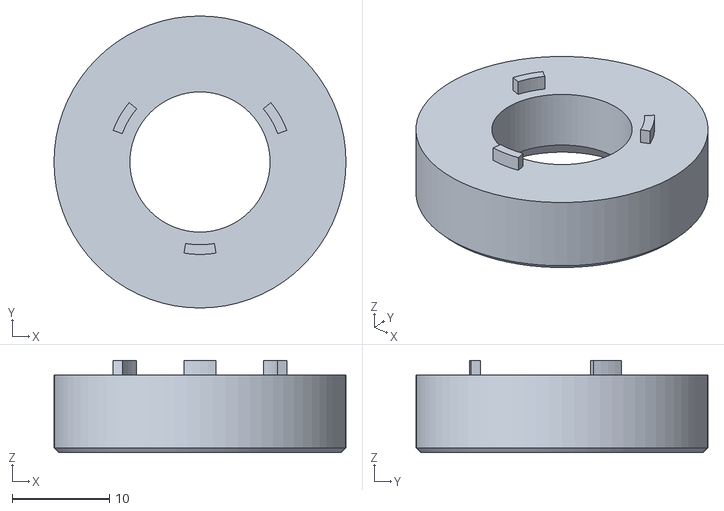
[picture p73: CAD file, 2026-10-27]
mechanical/body_parts/G05_034_noenoeil.stl
30.0 x 30.0 x 9.50
