Xiaomiju-x/rdk-x5-microduck/simulation/model/meshes/link_11.stl

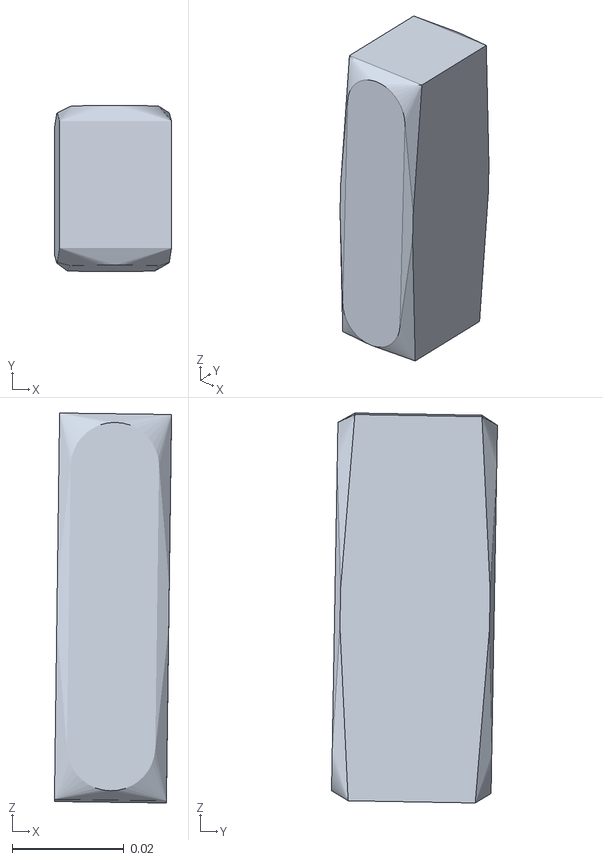
[picture p74: CAD file, 2026-10-27]
simulation/model/meshes/link_11.stl
0.0209 x 0.0296 x 0.0696
