Xiaomiju-x/rdk-x5-microduck/mechanical/body_parts/G02_077_01-upper.stl

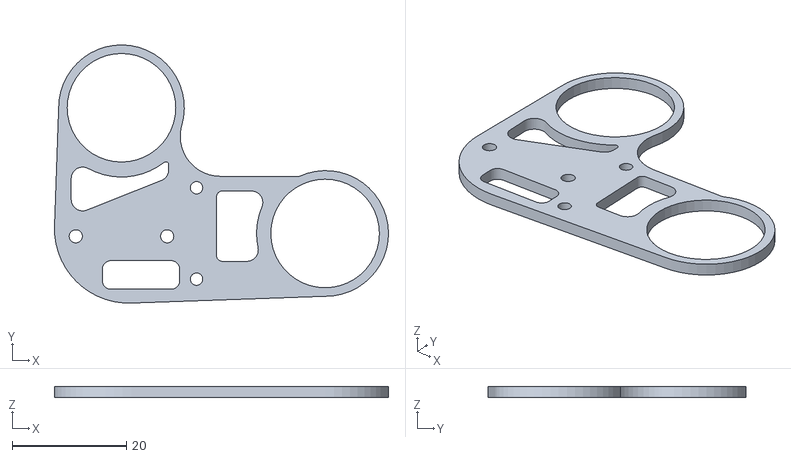
[picture p75: CAD file, 2026-10-27]
mechanical/body_parts/G02_077_01-upper.stl
58.5 x 45.2 x 2.00
