Xiaomiju-x/rdk-x5-microduck/mechanical/body_parts/G02_086_leg.stl

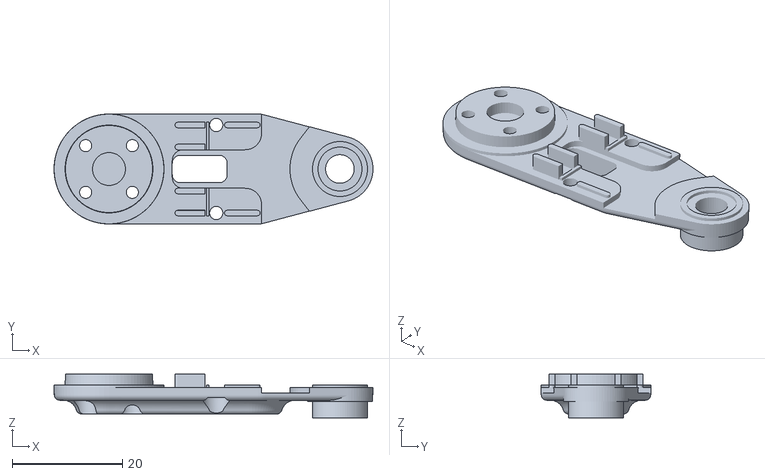
[picture p76: CAD file, 2026-10-27]
mechanical/body_parts/G02_086_leg.stl
58.0 x 20.0 x 7.95
