Xiaomiju-x/rdk-x5-microduck/mechanical/body_parts/G01_027_motor.stl

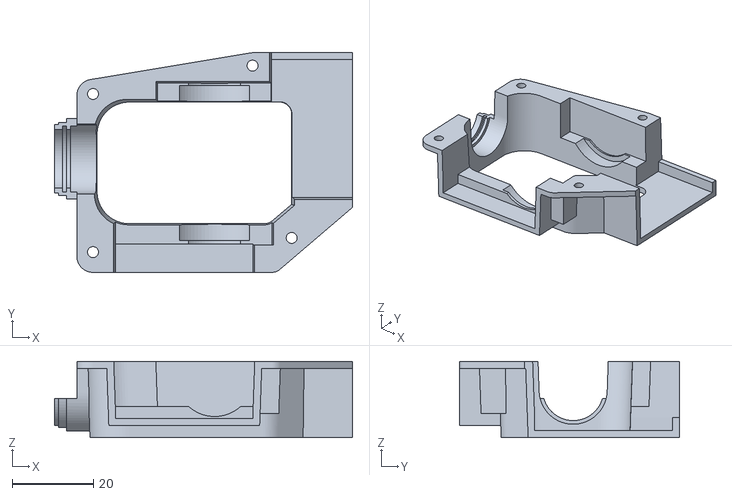
[picture p77: CAD file, 2026-10-27]
mechanical/body_parts/G01_027_motor.stl
73.5 x 54.2 x 18.8
