Xiaomiju-x/rdk-x5-microduck/mechanical/body_parts/G05_032_neck.stl

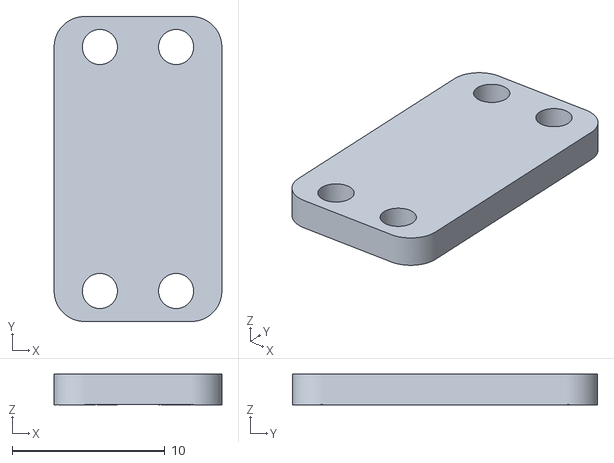
[picture p78: CAD file, 2026-10-27]
mechanical/body_parts/G05_032_neck.stl
11.0 x 20.0 x 2.00
