Xiaomiju-x/rdk-x5-microduck/mechanical/body_parts/G05_029_neck.stl

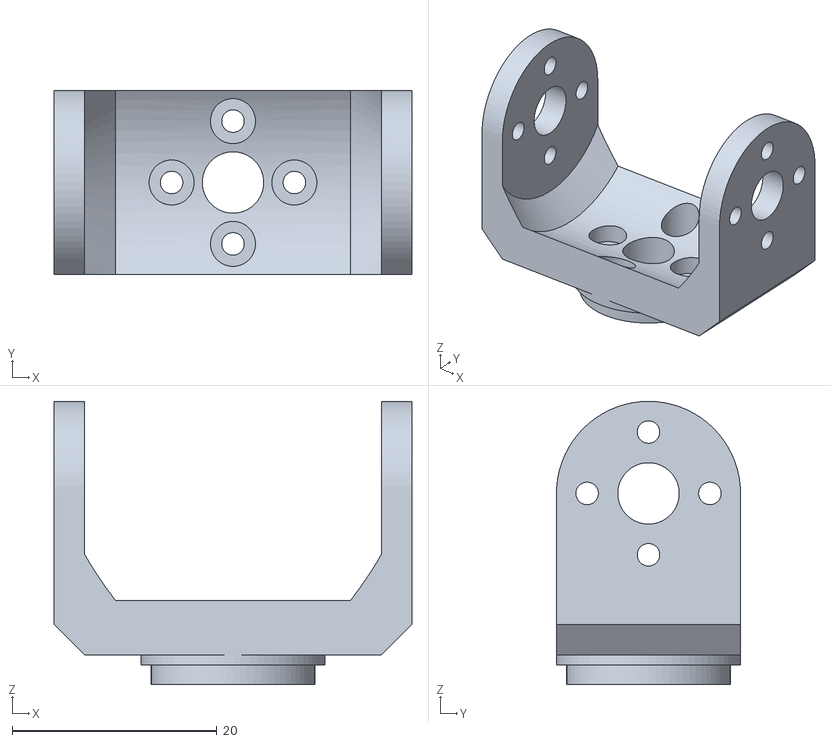
[picture p79: CAD file, 2026-10-27]
mechanical/body_parts/G05_029_neck.stl
35.0 x 18.0 x 27.7
