Xiaomiju-x/rdk-x5-microduck/mechanical/body_parts/G01_082_bearing.stl

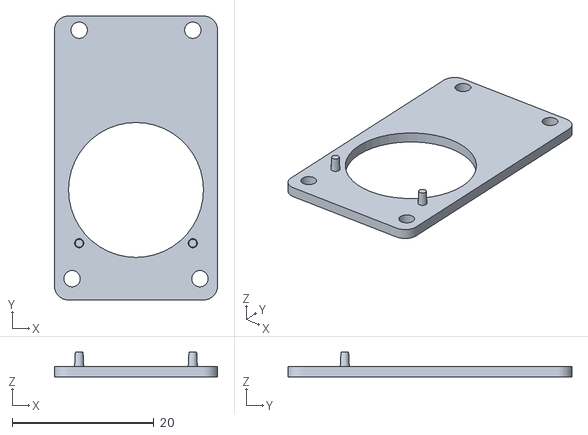
[picture p80: CAD file, 2026-10-27]
mechanical/body_parts/G01_082_bearing.stl
23.0 x 40.0 x 3.50
