Xiaomiju-x/rdk-x5-microduck/(list of files, cad)

Other CAD files:
mechanical/print_projects/MicroDuck_R8A_L2_ONLY_PLA.3mf
projects/pumpkin-duck/mechanical/mask/P08_LED_keeper_right.step
simulation/model/meshes/link_02.stl
simulation/model/meshes/link_06.stl
mechanical/body_parts/G02_073_right.stl
mechanical/body_parts/G03_012_foot.stl
mechanical/cad/R8A_print_parts.FCStd
mechanical/r8a_parts/L1_R8_short_FT_root.stl
mechanical/r8a_parts/L2_R8_flat_battery_portrait_X5.stl
mechanical/r8a_parts/S1_R8_PCB_spacer_6mm.stl
projects/pumpkin-duck/mechanical/mask/P00_fit_gauge.stl
projects/pumpkin-duck/mechanical/mask/P01_front_collar_R1c_closed_holes.stl
projects/pumpkin-duck/mechanical/mask/P02_rear_collar.stl
projects/pumpkin-duck/mechanical/mask/P03_chest_skeleton.stl
projects/pumpkin-duck/mechanical/mask/P04_pumpkin_imp_shell.stl
projects/pumpkin-duck/mechanical/mask/P05_OV2710_camera_cradle_R1a_header_open.stl
projects/pumpkin-duck/mechanical/mask/P06_CI1302_R1b_flat_foam_plate.stl
projects/pumpkin-duck/mechanical/mask/P08_LED_keeper_left.stl
projects/pumpkin-duck/mechanical/mask/P08_LED_keeper_right.stl
