Xiaomiju-x/rdk-x5-microduck/ASSEMBLY.md

# 从FT本体到机载X5：打印与装配

> 本页保留双电池成功基线的装配步骤。当前单电源实装已能站立，照片与电源升级见[当前样机](docs/CURRENT_PROTOTYPE.md)。

阅读顺序：先按[采购清单](docs/PROCUREMENT.md)备料，再按本页制作机械模块；上电前转到[部署与首次配置](DEPLOYMENT.md)。下文的“左/右”始终是鸭子自身方向。文件编号如075不是舵机ID，ID03也不是第3盘打印件。

本页采用 **FT本体 + R8A系列X5支架 + 实拍中的两侧电池/微雪固定 + TPU脚垫**。10月23日双电池历史样机见[硬件页正侧照片](HARDWARE.md#2-双电池历史样机布局10月23日)，前下方还有棕色附加安装/配重件。10月23日视频已经展示这条集成路线的短距离前进；原R8A电池占位与实拍已不同，本页区分结构设计与实际固定，不把CAD位置冒充成功当天的精确质量分布。

> 2026-10-27补充：当前推进R9单电池竖放、X5下移贴身与两半壳局部让位，设计/切片已完成并送印，实配待验证。以下仍为R8A/双电池成功基线的装配教程；[R9结构与单电源进度](docs/SINGLE_POWER_R9.md)另列，原打印文件不混换。

## 1. 文件下载与版本

| 内容 | 入口 | 用途 |
|---|---|---|
| FT整机源CAD、作者装配说明 | [机械行者Robo / fanhao375](https://github.com/fanhao375/microduck-replica-cad) | 选择飞特v2.0，勿混XL330件；源SolidWorks压缩包在上游Releases |
| 本案例选定FT本体STL | [28个硬件文件](mechanical/body_parts/README.md) | 每个文件1件；已剔除轮滑/旧备选，原052底板由R8A L1替代 |
| 本项目R8A下部打印件 | [文件与打印清单](mechanical/README.md) | 3种零件、6个实体；可编辑BRep FCStd、STEP和STL |
| R8A整盘打印工程 | [一盘六件PLA项目](mechanical/print_projects/R8A_SIX_PARTS_P1S_PLA.3mf) | 含修正后的下方螺母槽，打开后重新切片 |
| 左右TPU脚垫 | [脚垫STL](mechanical/tpu_soles)、[两件一盘工程](mechanical/print_projects/RDK_FT_LEFT_RIGHT_SOLES_P1S_TPU95AHF.3mf) | 保持原FT脚垫几何，只改变材料与打印朝向 |

本机FT参考固定提交为 `22ecf4daea158f2dfad7b633f730a5c04f1e04e0`。上游原五盘有52个对象及互斥备选，不等于每个对象都需装到一台鸭子；作者图解与实际FT零件以接口核对，不把v1 XL330图片当成FT舵盘剖面图。上游整机源文件通过官方仓库获取，本仓库提供与X5集成相关的增量件。

本次额外提供28件冻结本体网格和[52对象取舍CSV](docs/FT_PRINT_SELECTION.csv)，无需再自行从混合排盘猜选件。可编辑整机下载使用[固定v2.0 SolidWorks包](https://github.com/fanhao375/microduck-replica-cad/releases/download/v2.0/SolidWorks-FT.zip)；[固定STEP包](https://github.com/fanhao375/microduck-replica-cad/releases/download/v2.0/STEP-changed-parts-FT.zip)只有9份改动件，并非完整整机。R8A可编辑件仍在本仓库，源与哈希见[采购资料](docs/PROCUREMENT.md#5-可编辑源文件与固定版本)。

## 2. 打印材料与零件数量

| 部件 | 数量 | 材料 / 工艺基线 |
|---|---:|---|
| FT本体选定硬件 | 28 | PLA；历史准备基线0.2mm、6墙、15%填充、树支撑，按朝向与机器重新检查 |
| L1短根座 | 1 | PLA；0.2mm，6墙、50% gyroid，热床树支撑 |
| L2平电池托指＋竖X5架（R8A） | 1 | PLA；0.2mm，3墙、15% gyroid，允许模型面树支撑 |
| S1 6mm隔套 | 4 | PLA；0.2mm，3墙、100%，无支撑 |
| 046左脚垫、048右脚垫 | 各1 | Bambu TPU 95A HF；0.2mm，3墙、20% gyroid，普通紧贴支撑 |

公开3MF是 **Bambu P1S、0.4mm喷嘴、纹理PEI** 的可编辑项目，不含直接发送的G-code；切片前核对本机和耗材。PLA与TPU分盘。TPU 95A HF使用外置料架，不能映射成PLA或TPU for AMS。其他打印机需要重设机器与材料，不直接发送P1S配置。

L2保留中间细筋、两根托指与绑带槽，拆支撑时不要误剪。下方螺母槽在R8A已留出从上往下装入的开口；旧R8六件盘中的L2未做此修改，不应混用。几何文件以本仓库[manifest](mechanical/manifest.json)为准。

## 3. 下部支架五金

| 五金 | 数量 | 位置 |
|---|---:|---|
| M3×16螺丝、标准M3螺母、M3平垫 | 各2 | L1与L2两侧连接 |
| M2×12螺丝、标准M2六角螺母、M2平垫 | 各4 | X5四安装孔 |
| 原FT腿根舵机尾端螺钉 | 4 | 复用原对应位置固定L1；不是舵盘中心螺钉 |
| 约10mm宽、≤1mm厚细绑带 | 2 | 从托指槽穿过固定下电池；长度按实物留余量 |
| 薄泡棉与绝缘垫 | 适量 | 电池消隙、两侧模块固定、避开焊点 |

螺钉长度按头下长度计；M2螺母设计采用对边约4mm、厚约1.6mm的普通六角款。法兰、防松或加厚螺母不一定适配。PCB叠层对螺钉余长较敏感，不随意加厚垫片或换长螺钉。

## 4. 分步安装

### 开始前：把零件分成六盒

按[本体分组表](mechanical/body_parts/README.md)将髋部、双腿、硬脚掌、头壳、颈头连接、躯干外壳分开。027放入头部盒，它不是可省略的电子托架；031/032是两片连接片，不是两套脖子。小轴承10×15×3和大轴承16×22×4分装，先在空座中辨认尺寸。

给15只舵机贴纸标签：左腿01～05、右腿06～10、颈头11～14、嘴15。贴纸只帮助装配，不等于已写总线ID；电气编号另按部署工具逐只完成。将“主动输出盘”“另一侧副盘”“壳体安装孔”分清。拆副盘仅在相应FT装配位需要时进行，不拆齿轮箱、不把副盘中心螺丝误当主动盘周边紧固件。

### ① 先装FT本体并确认机械活动

依作者资料完成躯干、左右腿和头颈。记录每个舵机的物理位置与ID。先在断电状态检查各关节，区分驱动盘与非驱动侧副盘，不强掰，也不通过强拧螺丝消除错装造成的卡滞。原本体的轴承、舵盘、原螺钉沿用FT方案，不照搬其他鸭子的孔位。

#### A. 双腿：大腿 → 小腿 → 硬脚掌

| 模块 | 左侧零件 | 右侧零件 | 完成后检查 |
|---|---|---|---|
| 大腿 | 075＋一片077/078，ID03/04 | 073＋另一片077/078，ID08/09 | 上下关节轴线与FT模型一致，加固板自然贴合 |
| 小腿 | 084/086之一，接ID04与05 | 另一件，接ID09与10 | 线从开口通过；连接盘/支撑侧没有互相顶住 |
| 踝和脚 | 071＋012，ID05 | 069＋014，ID10 | 两脚尖朝同一前方，各小轴承自然落座，硬脚底平整 |

1. 大腿两端先把对应舵机、盘、轴承和加固板干装到位，再轻带全部螺丝。原配小自攻用于原盘周边孔，中心原厂螺丝不因此更换。
2. 小腿按FT结构接膝与踝。若非驱动侧副盘确实挡住本版承接面，按FT对应单盘配置拆掉该副盘及其中心螺丝；保留主动输出盘。不要用加长螺丝把不匹配的叠层拉合。
3. 每只踝的驱动侧按周边四孔连接，另一侧用10×15×3小轴承承托。没有横穿舵机的长轴螺丝；支撑侧不能省成悬空。
4. 当前只装硬脚掌，TPU脚底在后续步骤安装。脚掌与踝完成后，看实际接触面、螺丝伸入量、轴承座和运动空间，不仅看图上轮廓相似。

FT左腿装配关系

上图来自固定FT装配几何的局部关系渲染，表示组件位置，不是要求把腿掰成此角度，也不表示本机START计数。左右件虽相似，舵机计数增加方向并不相同，动作方向在上电联调时分别核对。

#### B. 髋部：圆孔平板、轴承和弯头在主动盘同侧

左侧用054、082、016和ID02，右侧用059、085、019和ID07。**主动盘应从圆孔平板的大孔露出，弯头接在这同一侧**；不要把弯头与圆孔平板分到舵机的两面。

| 先看主动盘侧 | 弯头与轴承合装 |
|---|---|
| 圆孔平板与主动盘 | 髋部合装关系 |

1. 将侧摆舵机装入对应直角架，让插口可达；壳体先与框定位，保留工具空间。
2. 圆孔平板对准主动盘一侧，主动盘穿过大孔。大轴承按对应外圆支撑座同轴落位。
3. 弯头用4颗原配小自攻接主动盘周边孔。顺序为螺丝头→弯头沉孔→打印薄底→舵盘小孔，保留盘中央螺丝。
4. 弯头另一垂直面接大腿上端；两端外围各自有相应大轴承支撑。四孔贴合面之间不夹一片轴承，但也不能漏掉外围圆座的轴承。
5. 再与腿根偏航关节连接。左右完整模块不能仅通过翻转某一个错装件来修正；检查主动盘、平板、弯头和插口四者关系。

完成后：两腿与躯干连接处不松晃，轴承内外圈未被螺丝跨接夹死；头颈、线束尚未装上时就应能看清腿根的固定路径。

#### C. 躯干：先根座与两腿，再合壳

本机载配置直接使用R8A L1替代052底板。ID01/06是躯干下方两只腿根偏航舵机；固定壳体和原支撑结构后接左右腿，保留尾端四处螺钉的可达空间。023/038身壳最后合，避免先封壳导致板底或总线插头无法处理。出现孔不同轴、盖壳翘起时，检查底板版本与线束，而不是用螺丝把外壳硬拉平。

#### D. 颈部和头内：横梁最后锁紧

颈根ID11、头俯仰ID12通过031/032连接片及029 U架构成头颈链。转头ID13、歪头ID14、嘴ID15使用080、027、010、021组成头内机构。此处先保留主动盘和所有需要的轴承，确认双盘/单盘位置后再装壳。

1. 031/032连接片按两侧孔连接颈部，029 U架两耳与对应盘连接。安装主动盘周边小螺丝，不拧原厂中心螺丝改变机械零位。
2. 先把ID13和080转接架准备好。接080底面的非驱动副盘按该FT装配位移除，保留需要输出的主动盘。两颗大轴承位于080对应圆形支撑处。
3. ID14主动盘连接080一侧；ID15主动盘连接021下巴驱动耳。下巴另一侧的10×15×3小轴承单独放入对应座。
4. 将转头组、歪头/嘴舵机、两大一小轴承和下巴落入010下壳。先插好线并从开口引出，别把线压在轴承座或横梁柱顶。
5. **这些部件均落座后才放027横梁。** 用4颗M2.5×8轻带入四柱，再交替轻紧。横梁应落在柱顶，不能悬在舵机上，更不能用螺丝压下未落座的轴承。
6. 接脖子U架和头部，检查活动空间。050上盖最后用另3颗M2.5×8固定；头内4颗与上盖3颗分别计算，共7颗。面板056、眼圈034作为外观件最后安装，不遮住调试用的线和接口。

| 横梁盖下之前 | 横梁落座之后 |
|---|---|
| 先放好头内组件与轴承 | 头内横梁落到柱顶 |

这组图是FT原装配几何与冻结打印件的关系图，未绘出全部螺丝。实际装配以对应孔位、接收孔牙型、轴承落座和没有夹线为准；不能把局部渲染当成新一轮全行程干涉验收。

### ② 换L1短根座

断开两路电源和USB，支撑好头部及躯干，卸掉旧远悬背包载荷。L1替换原对应底座，不叠在旧底板上；短梁朝鸭子后方。T1～T4是原腿根舵机尾端四个孔，保留原轴座与接口，原螺钉按原位置复用。

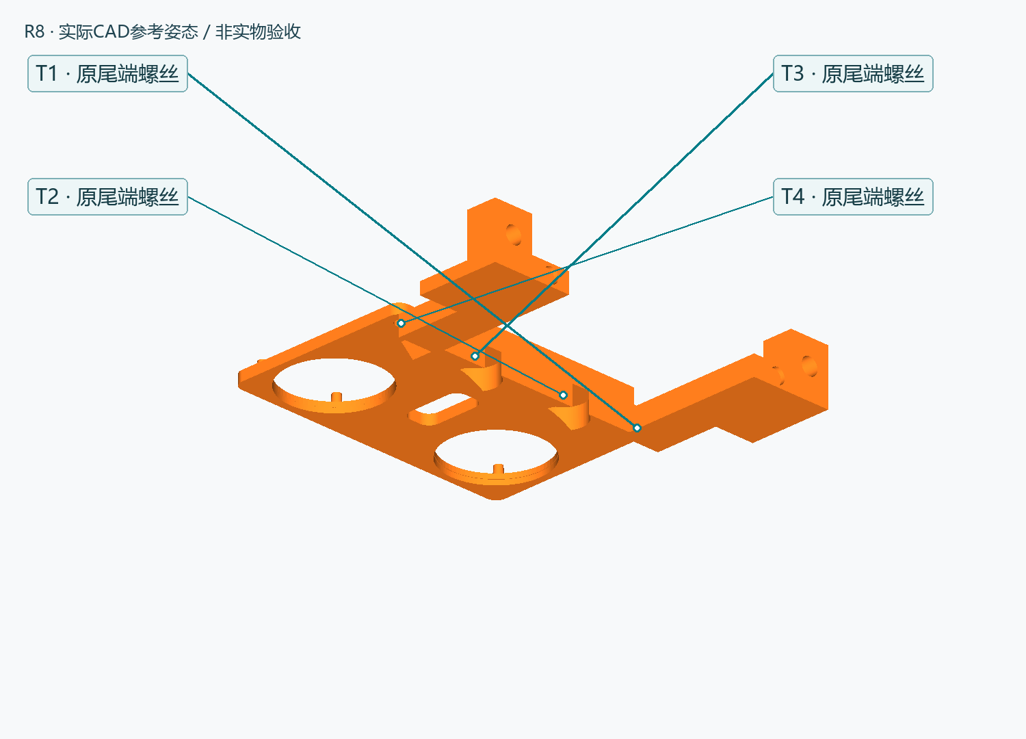
[picture p81: docs/assembly/05_root_holes_labelled.png]
L1原四孔


### ③ 离机准备L2和螺母

清理支撑、通孔、绑带槽和下方两螺母装入口。四个M2螺母先放好，再安装X5；R8A下方两颗从槽上方朝下滑入，保留底部六角定位。不要因装不进去就扩大PCB孔或把螺母强压进PLA。

R8A下方螺母入口

L2仍保留原设计的平电池托指及绑带槽。下图是**原设计托盘的装配参考**：70mm左右、40mm前后、19mm高度，薄泡棉消隙、绑带防脱。10月23日成功照片的电池已移到机身两侧，不要照下图再额外装第三块电池，也不要将这张局部CAD图误认为当前整机布局。无论采用哪一固定位置，都不能让电源线承重。

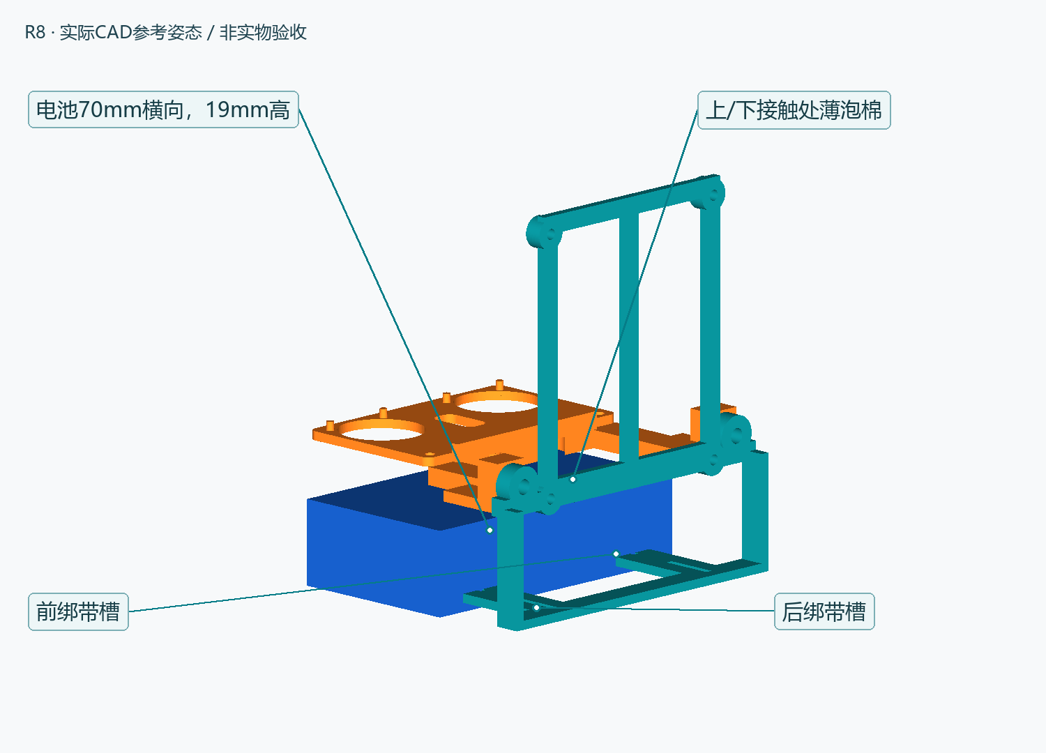
[picture p82: docs/assembly/08_flat_battery_labelled.png]
平放电池及托指


### ④ 将L2接到L1

两侧各一套M3连接：**螺丝头 → 平垫 → L2孔座 → L1后端孔座 → M3螺母**。连接孔中心距64mm。托住电池/支架组件再锁紧，不通过拧紧让错位零件强行变形。图中爆炸间距仅便于识别，实装两接触面贴合。

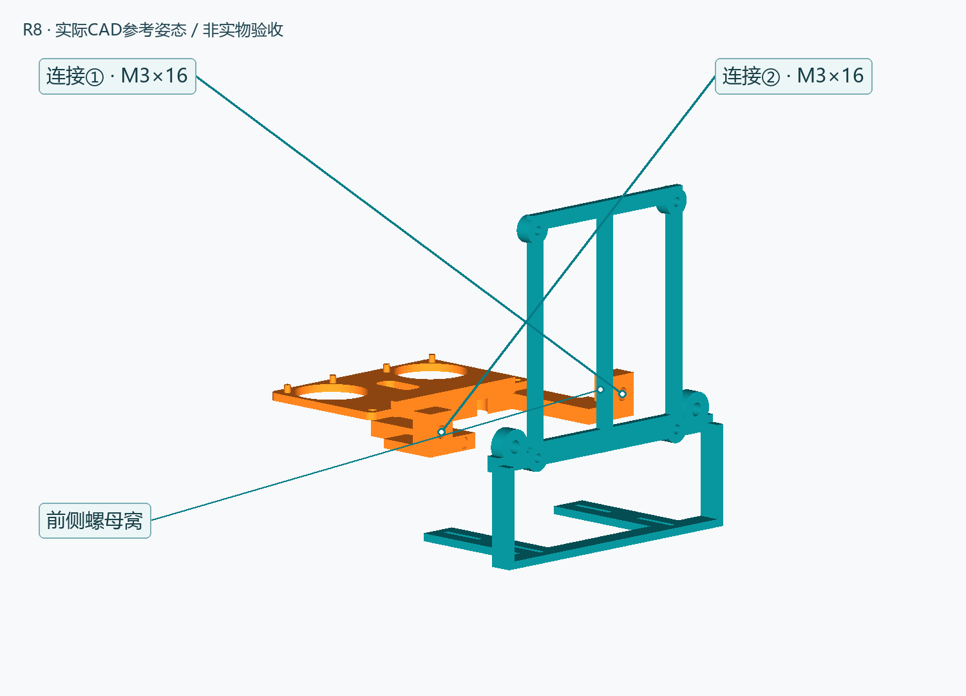
[picture p83: docs/assembly/06_root_to_holder_labelled.png]
L1与L2连接


### ⑤ X5竖装，四孔留隔套

X5长边竖起，接口/元件朝外，孔组按实际板卡对齐。叠层从外向内为 **M2×12头 → 平垫 → PCB → S1 6mm隔套 → L2孔座 → M2螺母**。四颗先全部对上再轻紧；不要压在焊点上，不用泡棉整面封住板卡。板孔名义间距约49×58mm，不能因板外形接近树莓派就套用其他孔组。

X5与四个隔套

以上装配关系图沿用R8局部渲染，**实际下载与下孔螺母入口以R8A模型和第③步图为准**。图中X5模型仅用于说明叠层；公开打印CAD不包含厂家整板模型。

### ⑥ 按实拍固定两侧电池与微雪

按[当前正面照片](media/20261023/onboard-front.jpg)及[侧面照片](media/20261023/onboard-side.jpg)，两块电池分布在固定躯干两侧，微雪板以绝缘泡棉固定在一块电池外侧。先干装确认头颈和腿根活动空间、插头方向和电源开关可触达。胶点避开板底器件、焊针与热源；不把电池绑在活动颈部或腿部。侧面固定没有新增专用打印件，需根据实际壳体接触面和电池外形做好防滑、防剥离与防脱。

成功照片前下方还有棕色附加安装/配重件，此处如实保留该事实；尺寸、材料、质量未独立记录，不能声称已获得不带配重的同条件结果，也不能按照片猜一个统一克数。复刻时记录自己附加件的重量和位置，再用控制台逐轮调整。不要混用旧重型远悬背板、顶部电池占位图和当前两侧安装照片。

### ⑦ 装TPU脚垫并收线

保留原硬脚掌、脚踝、舵机，只更换脚底套。清掉裙边和凹槽中的支撑，再分别装046左和048右；这两个是打印件编号，与舵机ID无关。薄包边不要用大力拉扯；检查贴合、两脚触地和防脱。

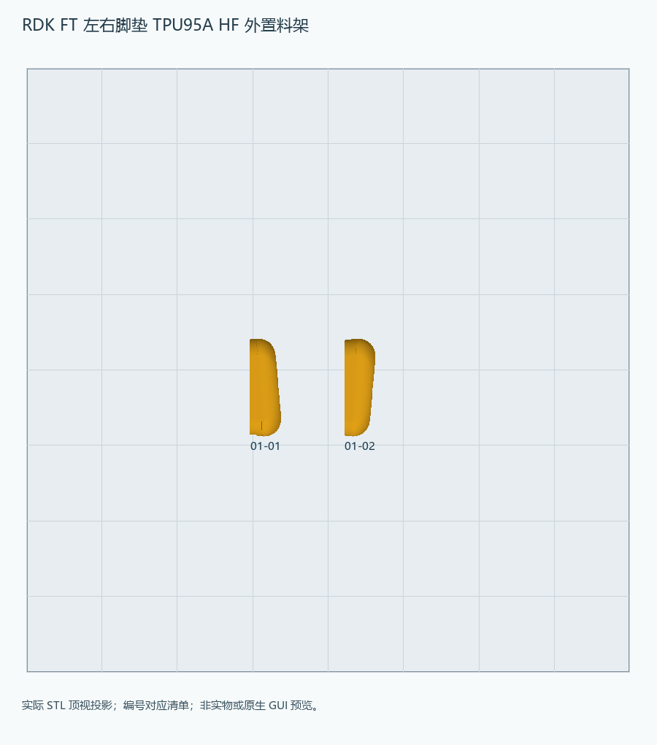
[picture p84: docs/assembly/tpu_plate.png]
TPU两件一盘


两电池分别就近供板卡，信号线沿固定躯干收束，腿间不留易勾住的大线圈。给髋、膝、颈和插头留活动余量；IMU保持固定和原朝向。[完整接线](HARDWARE.md#3-双电池历史基线的电源与信号连接)。

### ⑧ 建立本机站姿，再逐步验证

检查根座无裂纹、螺母已坐实、电池不滑移、线缆不拉扯；托住本体逐步承载附件。新机先核每轴ID/方向与本机START，再悬空检查小动作，最后有人接护试站与单轮短步。更换TPU、载荷或安装位置后需要重新观察，不能把程序“回START”直接当成现场已站稳。动作与参数流程见[部署说明](DEPLOYMENT.md)。

## 5. 我们遇到过的装配问题

- **大腿托架定位柱偏短**：本批曾出现只到孔口、不能有效插入的情况。做过柱端加长1.5mm候选，但用户最终优先保留原结构固定方式。不能把候选改件作为所有复刻机必改；定位柱也不是有螺纹的紧固件。
- **舵盘与脚踝叠层干涉**：先核对需要保留的驱动盘及应拆的副盘，不直接缩薄承力件。更长螺钉需检查盲孔余深，不能盲拧。
- **孔对上但螺母进不去**：R8A专门增加下部两颗M2螺母的装入通道，装配顺序改为螺母先入位。最终位置有空间，不等于工具和螺母有装入路径。
- **旧背包远离本体、连接处断裂**：因此收近下部电池和X5，缩短悬臂，取消大背板；结构位置和质量分布一起处理。局部CAD检查不等于PLA强度认证。
- **工程图视角混乱**：左右始终按鸭子自身；爆炸图分离距离不是实装间距。只使用同版FT接口和本页R8A文件。

## 来源与文件许可

FT结构由机械行者Robo建模、fanhao375整理，源于Pollen MicroDuck生态。包含FT接口的R8A底座、相关衍生CAD/STL和脚垫依 [CC BY-NC-SA 4.0](https://creativecommons.org/licenses/by-nc-sa/4.0/) 保留署名、非商业、相同方式共享；详见[机械文件说明](mechanical/README.md)。源码许可和媒体许可分别见[NOTICE](NOTICE.md)。
