Xiaomiju-x/rdk-x5-microduck/docs/BUILD_CHECKLIST.md

# 从拆箱到首次短距离前进：逐步交付表

按顺序完成，每步都留下一个可以回看的结果。无硬件读者完成第1步后可进入仿真教程；实机复刻者继续第2～9步。本文是一张执行索引，详细命令在[部署教程](../DEPLOYMENT.md)，机械操作在[装配教程](../ASSEMBLY.md)。

| 步骤 | 做什么 | 应得到什么 | 不符合时查哪里 |
|---|---|---|---|
| 1 · 获取固定版本 | 下载本案例Release，阅读README，运行离线测试/plan/DEMO | 测试通过；5轮plan为2000帧、0动作写；页面明确DEMO | 软件环境、文件是否完整；不要把demo页面当作已连接实机 |
| 2 · 清点采购 | 依据采购表核对15舵机、板卡、IMU、供电、轴承和螺丝 | 一张填好实物型号/数量的清单 | 型号和接口，尤其(A)小板、HD1910M、TTL IMU、输出电源 |
| 3 · 打印选件 | 本体28件＋R8A六实体＋两TPU脚底；PLA/TPU分开 | 正确左右件、无旧备选重复件；支撑清理后小孔/轴承座可辨认 | 52对象决策表、打印单位、材料、缩放和支撑 |
| 4 · 装机械模块 | 腿、髋、躯干、颈头、R8A；逐处核对驱动/支撑侧 | 无靠螺丝拉弯的错装；每只舵机位置明确；线能从缺口引出 | 髋同侧结构、头内横梁顺序、踝副盘与轴承、下孔螺母通道 |
| 5 · 只接主机和传感器 | X5启动、网络可达、两个USB串口能区分、IMU有新数据 | 系统/串口记录，机身前后倾读数符号可解释 | 系统镜像、驱动、供电、端口权限、TX/RX、波特率和IMU格式 |
| 6 · 逐轴建档 | 用对应FT工具核唯一ID/模式/方向，然后公开包只读inspect | 1～15各一只回复，位置/模式/offset与实际记录一致 | 重复ID、总线接反、模式差异；不先套原型START |
| 7 · 本机START | 正确机械站姿、稳定支撑下只读capture，人工核对后启用配置 | 15轴参考位置＋offset、方向和IMU安装配置，附正侧照 | 错误关节姿态、错轴、姿态在采样时移动 |
| 8 · 悬空单轮 | 现场托稳卸重，先慢复位，再单轮小动作，结束检查 | 两腿交替动作、头颈随设定变化、无卡碰；记录实际观察 | 装配间隙、方向、供电、反馈与目标差异；不要直接连续5轮 |
| 9 · 落地单轮 | 平整防滑面，自行站稳、线缆留量、人在旁接护后运行 | 记录是否前移、何时倾倒、需不需要接住、收步能否站稳 | 每次只调一项，区分启动角、走动角和提前收颈 |
| 10 · 连续轮研究 | 单轮现场效果清楚后，再自行选择2/3/5完整周期 | 每轮的日志和实际起停观察，保留失败轮次 | 软件完成不代替稳定验收；停止/故障后不自动接下一轮 |

## 第一轮之前保存四份材料

1. 正面与侧面站姿照片，能看清脚底、躯干、板卡和电池；另拍IMU轴向。
2. 本机设备配置：端口、ID/方向、模式、offset、START、IMU安装旋转。
3. 当轮颈部参数与轮数；成功原型参数在 `software/config/success_20261023.json`。
4. 本轮日志和一段完整起步—前移—收步视频，注明手是否持续支撑。

这些记录用于区分“动作目标相同”与“现场条件相同”。公开求助时去掉设备序列号、内网地址和个人信息，保留错误文本、版本、相对误差和现象。

## 前后倾时按哪个阶段调

| 现象 | 首先观察 | 单项微调入口 |
|---|---|---|
| 刚启动就前倒 | 站姿是否正确、头颈后移方向是否已核 | 启动颈角，小步改变后重复同一单轮 |
| 走动中后倒 | 前移段是否真正执行，电池/线缆是否改变受力 | 走动颈角，与启动角分开 |
| 最后收步前倒 | 颈是否在腿部收尾后才返回 | 提前收颈时间，每次只改一个小步 |
| 悬空正常、落地幅度很小 | 同轮目标/实际位置、失能、电源支路、负载 | 先看反馈，不将所有差异简单归于“代码没动”或“重量太大” |
| 位置中途停住 | 日志中的通信/故障/停止原因 | 先托稳检查实际状态，再决定复位；不自动连续重试 |

调参后保存自己的配置，不覆盖原型基准。当前短距离路线和后续单电池、线束集成、长距离、RL闭环路线见[ROADMAP](../ROADMAP.md)。
