Xiaomiju-x/rdk-x5-microduck/simulation/verification/README.md

# 本次离线检查记录 · 2026-10-27

这些JSON由随包 `run.py` 实际生成，不是手填预期结果。数字表示教学模型结果，不是实机测量。

| 文件 | 实际执行 |
|---|---|
| inspect.json | 裸机模型载入，15转动关节/14执行器，0.611kg |
| hold.json | 自由基座、参考目标保持，2秒/400物理步；最大倾斜约2.50° |
| joint.json | 固定躯干悬空双膝教学响应，2秒/400步；两膝摆幅约6.48° |
| payload_inspect.json | 显式添加假设84g方块，模型质量0.695kg |
| payload_hold.json | 同假设方块2秒保持，发生翻倒；脚以外碰撞未建模，翻倒后的穿地无实物预测意义 |

另用独立新建Python虚拟环境安装 `requirements.txt`，运行4项 `test_simulation.py` 测试。模型、悬空与附加质量检查不需要显示器。渲染截图/2秒MP4在Windows的OpenGL环境完成，并目视检查模型实体显示和视频用途标记。

`complete`是本次积分是否完成，`warning_counts`是MuJoCo数值警告，二者均不是物理稳定验收。没有训练、策略推理、串口、SSH或X5操作。
