Xiaomiju-x/rdk-x5-microduck/history/ROADMAP_20261023.md

> 历史快照：2026-10-23。现行内容见[方案主页](../README.md)。

# 后续路线：巩固机载短距离前进，推进V2机内集成

## 当前路线 · 2026-10-23

**已完成突破节点：RDK X5、微雪小板、电池全部上身，取得短距离前进演示。** [实拍与配置](../progress/2026-10-23/README.md)

1. 保留本次D小动作与分段收颈配置，固定地面、初态、装载和供电条件，逐轮记录起步、前移与收步效果。
2. 继续优化贴身布局、结构轻量化、线束固定与维护；不靠不断增加前后配重掩盖布局问题。
3. 推进更长距离和连续起停；全身实时闭环、模型适配与训练作为独立路线验证，不把新权重的训练完成等同于实机通过。
4. **V2目标是机内集成，不外挂**：与硬件同事协同机械源模型、板形/孔位、配电、IMU、调试与散热空间；电路方案和交付时间以实际评审为准。
5. 陆吾副线保留独立实机对照；南瓜鸭副线继续实物装配及互动联调，数字瓜园成果独立记录。资源与对外叙事均以RDK主线为重点。

---

## 历史计划 · 以下保留2026-09-29与10-19记录

2026-10-19 更新：现有 X5、微雪小板与电池已外挂到机体，可正常站立；当前重点转为减轻配重、优化结构布局及继续带载行走调试。以下保留9月29日原计划，不能将计划条目全部视为已完成。

日期：2026-09-29。以下均是后续计划，不写成已完成设计或已购买物料，也不承诺未经确认的交付日期。

## 第一版里程碑冻结

保留当前打印结构、R3站姿、关节映射、源目标片段、微调参数和完整演示视频。短距离行走阶段先收口；后续测试作为新版本记账，不覆盖本次结果。

## V1.5：利用现有板卡的可拆卸背包

不等待定制板，继续复用完整RDK X5和微雪Bus Servo Adapter(A)，另选合适电源，制作竖向、贴近躯干的打印安装件，让机体能够携带这套设备。

建议实现步骤：

1. **量尺寸与称重**：X5（含散热器/风扇）、小板、电源、线材、插头空间逐一记录。电源型号未定，不先画成固定电池尺寸。
2. **先摆件再定重心**：竖装不是把所有部件堆到头后面；尽量靠近躯干，较重电源优先低位，并留前后调节位置。称量未完成前不宣称满足承重。
3. **模块化打印**：主体安装框、X5固定架、小板固定座、电源托座/绑带分开，便于拆修。固定到承力结构，不只靠薄外壳或泡棉承受整包重量。
4. **电气与维护**：核对电源输出、峰值电流、支路、线径、极性及接口；保留可触及电源开关/断电点、USB维护口、散热和插拔空间。不得把未知电池直接并联或给板卡混接电压。
5. **先装静态，再走动态**：空架试装→等效负载→电子件上身→站姿与线缆检查→有限短步→收步。记录带包总重、位置及参数，和台外版分开对照。

输出：可编辑CAD、STL、BOM、装配图、按实际打印机生成的切片，以及带包版实拍和验证记录。**本次发布只明确路线，背包CAD和电源采购尚未完成。**

## V2：X5 Module + 专用底板

专用硬件继续与硬件同事协作，时间以方案与评审进展为准，不再把旧“月底完成”的预期作为已兑现承诺。

- 目标是减小体积和线束、优化配电与安装，而不是为一体化重做已经可复用的腿部结构。
- 先定义Module、舵机总线、电源、IMU、调试与散热接口，再进行原理图/PCB/结构协同。
- 用实测总重、CoM与执行器响应更新模型；需要时再调整/训练策略，保留原版对照。
- 逐级验证上电、通信、有限动作、起步/行走/收步与重复性，再扩展交互功能。

## 两条软件路线保留，但不虚报进度

常规线复用Placo/Open Duck参考生成器，用于运动学与动作解释；RL线复用官方Microduck框架，已做原策略仿真、X5推理与有限实机适配。当前没有宣称新训练完成。后续根据带包质量分布与执行器辨识结果决定适配和训练投入。

## 可见成果节点

| 节点 | 对外可展示的结果 |
|---|---|
|当前阶段|完整演示视频、硬件链路、代码与复盘|
|背包试装|CAD/爆炸图、BOM、接口与散热检查|
|带载验证|总重/配重记录、站立与短步对照视频|
|第二版电控|经评审的接口/BOM/原理图与样板验证记录|
|稳定性迭代|固定条件下的起停重复试验与明确测量方法|

每个节点完成后更新原社区帖与公司内部项目文档，不等全部完工才同步。
