Xiaomiju-x/rdk-x5-microduck/BUILD_LOG.md

# 从双关节到短距离行走

> **最新进度｜2026-10-30：** 当前单5V电池样机已能正常供电、启动和站立，带载行走出现供电不足表现。已采购2S 1000mAh 45C电池、好盈5A UBEC（5.0V供X5）、分线/转接线及S10充电器，预计11月2～8日到货验证。[完整采购清单、新接线与后续安排](progress/2026-10-30/README.md)。下文10月27日电源说明保留为历史；旧DC端子直供X5的接法禁止用于新2S电池，新方案尚未验收。

## 2026-10-30：单电源样机实拍与首页更新

项目首页和个人主页采用完整展示RDK X5的单电源背面图，补齐当前正背面实拍；当前已能站立，行走供电不足仍待新电池与UBEC对照验证。旧双电池照片、10月23日成功视频、冻结参数和固定Release保留为历史基线。同步当前样机说明、硬件页和后续路线，避免旧的“当前布局”标签混淆两版。[当前单电源样机](docs/CURRENT_PROTOTYPE.md)

## 2026-10-30：南瓜鸭活动副线结项归档

以已制作的白色南瓜面具、桌面瓜园和活动展示资料收尾，独立保存[中英文结项档案、实拍照片、面具修正版 STEP/STL、实装问题与未完成拓展](projects/pumpkin-duck/README.md)。视觉/语音软件、桌面驱动侧与插头净空适配、整套实物互动尚未完成；数字版回放与流程测试不替代实体验收。后续不再主动推进本副线，原夜间自动化保持停止。主线开发和固定 Release 独立保留，本轮没有训练、实机动作或打印。

## 2026-10-27：24章手册同步与单电池供电启动

地瓜社区教程扩为六篇24章，本仓库同步完整正文、可点击目录及装配/R9示意图。硬件说明、采购基线、README和后续路线一起更新，避免新旧页面对单电池状态描述冲突。

现场操作者确认：一块现有成品5V舵机电池，经微雪DC+/DC−分供，X5与15个舵机能正常供电、启动。该结果不代替带载行走、连续运行、动态电压或温升验收。10月23日成功行走视频仍为双电池，单电池当前文字实测记录见[进度页](progress/2026-10-27/README.md)。

R9将电池竖放、X5相对保存的R8A CAD下移24mm并内收约3.64mm，修改根座、轻量托架与两片躯干局部让位壳；已设计、切片并送印，实配待验证。后续按R9实配、单电池带载、线束整理、D单轮复现与长距离、RL闭环推进。发布过程没有连接机器人或改变控制代码/参数。[完整手册](docs/FULL_SOLUTION.md) · [当前路线](ROADMAP.md)

## 2026-10-27：从发布总览补齐为完整复刻案例

围绕复刻顺序重写15章完整案例，新增采购、52对象选件表、成功原型配置卡、首次运行教程和机体坐标说明。选定28个本体STL随包提供，与R8A六实体及两TPU脚底配套。系统全景把机载D执行、软件离线验证、FT教学仿真与后续RL路线分别说明。

公开软件增加独立只读IMU诊断，34项离线测试通过，成功D轨迹/颈部算法/参数保持；提供CI与Issue模板。新增可运行MuJoCo教学环境，4项测试、自由基座短保持和固定躯干双膝实验已实际完成。没有新实机动作，也没有将教学仿真作为RL走稳成果。

后续安排明确为一块电池、减少线缆裸露、长距离行走和RL实时闭环验证，V2机内集成并行推进。[完整案例](docs/FULL_SOLUTION.md) · [本版说明](RELEASE.md) · [后续安排](ROADMAP.md)

## 2026-10-26：完整参考方案集中发布

围绕现有RDK X5机载原型，整理硬件BOM、接线、R8A轻量支架与TPU脚垫、装配说明、D公开运行包和可视化控制台。推荐入口统一为`software/`，旧源码和实测记录保留作历史对照。新公开包使用相对目标序列、外置逐机配置，并进行离线等价性及流程检查；本次发布没有新实机动作。

连续2、3、5轮保留每轮完整400帧，默认单轮；完成离线检查和原本地新版同步，但多轮实机稳定性待验证。[方案总览](docs/FULL_SOLUTION.md) · [发布说明](RELEASE.md)

## 2026-10-23：突破性进展——全套硬件上身后短距离前进

在10月19日“板卡和电池上身、能够站立”的基础上，RDK X5、微雪小板与电池均由机体携带时，取得了短距离前进并收住的实拍结果。这与9月29日的桌面外接方案是不同的集成阶段。

这期间持续处理安装距离、结构重量、供电支路、关节跟随和动作衔接。多版本微调台保留了历史小动作，现场发现其仍可缓慢前移；随后将11号颈根启动角和走动角分开，并让平滑收颈提前进入，改善最后收步的前后倾衔接。本次演示配置已保存为默认并独立备份。

[完整录像、正侧照片、冻结参数与控制模块](progress/2026-10-23/README.md)。本次不是新RL模型行走验收，实际距离未做标定测量；后续重点是固定条件下的起停重复性与更长距离稳定性。

## 2026-10-19：机载集成与带载调试进度

RDK X5、微雪舵机小板与电池已全部外挂安装到鸭子本体，能够正常站立。当前整机负载偏大，正在优化布局、减轻配重，带载行走仍在推进。本次为常规研发记录，不作为新的行走突破或稳定性验收。

[10月15日实机照片](backpack-standing-20261015.jpg) · [同日完整视频（约17.5秒）](backpack-progress-20261015.mp4)

以下是已发生的工程过程，而非倒推的一条“一次成功”路线。日期按本项目记录整理；细分实验不等于成熟功能验收。

## 9月上旬：选型与复用

确定使用 RDK X5，并优先复用开源 MicroDuck 结构和步态框架。早期做过单腿结构与电子件托架方案；随着飞特整机 CAD 可用，转为 HD1910M 整机结构复刻，没有继续从零重画整机。老版单腿和新 FT 结构不能混装。

## 9月14—18日：打印和装配准备

核对机械行者Robo/fanhao375 的 FT v2.0 文件，原五盘工程含备选件和轮滑件，不等于唯一整机 BOM。针对本机 P1S 重设打印参数、重新排盘为六盘，检查混入的旧底板版本。随后处理托架定位柱插入长度、脚踝配合、舵盘拆装说明等问题，左右件分别核对。

重要教训是：图画得漂亮不代表装得上。装配图必须说明“哪一面、哪只舵盘保留/拆除、螺丝从哪里穿、哪个轴承放在哪里”。有些早期自制说明确实漏标，后续依据实物反馈修正，不能将这些返工归为操作者问题。

## 9月15日：双关节验证

X5 + 微雪 Bus Servo Adapter (A) + 两只 HD1910M 在旧版台架上完成低速往返与位置/电压/温度回读。这是接口可行性验证，不是整机承重或行走通过。

## 9月25日：整机站立与嘴部演示

15只舵机完成编号和通信，整机装配完成。现场调出可站立 START 目标，通过 X5 演示嘴部张开约20°后闭合，并将正面照、侧面照和视频更新至[地瓜原帖第2楼](https://forum.d-robotics.cc/t/topic/35728/2)。

同期确认常规步态和官方 RL 两条复用路线，接入 JY901S。START 是这台机器的目标快照，不是精确模型零位，也不是断电后自动站立功能。

## 9月26—28日：实机方向、结构与 sim→real 核对

补齐关节方向、悬空动作和落地对照。期间有托架朝向、颈部安装与编号理解反复，四个腿部 ID 交换后来被恢复；最终应以实际关节位置与方向确认表为准，不根据照片视角猜左右。

全身逐项检查发现11、12号的旧方向记录反了，重新实测后修正。MuJoCo可视化与实物对照涵盖腿杆、关节轴、默认姿态、IMU坐标、质量与惯量。原模型包含机载电子件/电池，当前桌面外挂不算机体质量；因此不能称动力学已完全匹配。

早期八腿“仿真实际角回放”不是完整策略部署。离线对照发现，用 actual 再当 target 会改变执行器动力学；于是转为核对真实 action→target→actual，并在 X5 跑原策略推理链路。

## 9月29日：承重对照、改线与阶段演示

1. 从视频发现走动前倾，分开检查站姿接管、承重跟随与动作切换。
2. 对同一组实际下发目标做悬空/落地对照，右膝与右踝承重时跟随明显变差。
3. 将右腿从经左腿末端串接改为小板直接支路，跟随改善；这不等于已证明唯一供电根因。
4. 完整策略中，早期小动作能前移，而后段幅度增大时容易失稳。保留失败视频，不将完整指令下发等同于稳定行走。
5. 最初“保留前两秒逻辑”仍会由新反馈生成不同目标，后来明确改为真实 sent_targets 的固定片段；即便目标一致，物理起态与跟随也可能不同。
6. 增加11号实时相对俯仰补偿，将参数和配重记录做成可视化微调台，由现场操作者自行微调与反复确认。
7. 取得本仓库展示的短距离行走阶段成果。最新约20秒视频包含短步动作及整套外挂硬件，后续重点转向背包集成与稳定性优化。

## 9月29日当时的验证边界（历史）

暂不为演示反复新增试走，不宣称新 RL 训练完成，不把短片外推为任意负载稳定行走。保留当前可展示版本和参数，后续新负载形成新版本，与本阶段数据分开。
