Xiaomiju-x/rdk-x5-microduck/history/RELEASE_20261026.md

# 2026-10-26 完整参考方案发布

本次集中开放机载RDK X5 Duck的硬件、机械改件、装配、D控制、部署与调试资料。实机成果依据为2026-10-23的全机载短距离前进视频和照片。

## 推荐入口

- 软件：`software/`，单一D控制台，默认单轮。
- 参数：启动0°、走动请求−30°、保持0秒、过渡0.2秒、提前收颈1.1秒、自动双向增益0。
- 机械：`mechanical/README.md`所列选定改件及上游FT本体。
- 设备：各机独立配置串口、模式、offset、START与IMU安装方向。

## 验证的含义

| 内容 | 证据与边界 |
|---|---|
| 全机载短距离前进 | 10月23日原型实拍，前进后展示硬件；距离未标定 |
| 成功D动作与颈部时序 | 原版本现场微调结果已冻结 |
| 本次便携公开包 | 从原链路提取，进行离线轨迹、参数、协议与流程检查；未在实机重新运行本次打包版 |
| 连续2/3/5轮 | 完整单轮依次重复；离线通过，实机多轮待验证 |
| 实时RL、长距、V2集成 | 后续研发路线 |

根目录早期Python模块、9月29日ZIP及历史记录保留原样供比较，新部署使用`software/`。本次发布没有操作实机或重新测定质量、质心、续航。
