Xiaomiju-x/rdk-x5-microduck/(commit log)

2026-09-29 Publish 2026-09-29 short-walk milestone, sources and engineering notes
    Includes complete 20-second milestone footage, two earlier diagnostic videos, curated source archive, assembly lessons, hardware mapping and backpack/V2 roadmap. No private network configuration or policy weights.
2026-10-26 release: complete RDK X5 Duck reference with portable D runtime and CAD
2026-10-27 release: complete reproducible RDK Duck case with hardware, software and simulation
2026-10-27 fix: preserve servo behavior with Python 3.10 compatible trace formatting
2026-10-27 docs: sync 24-chapter handbook and single-battery startup progress
2026-10-30 docs: record single-power load issue and 2S UBEC procurement
2026-10-30 docs: close and archive Pumpkin Duck Garden side project
2026-10-30 docs: feature current single-power Duck prototype and rear-view banner
